WindraNatan/Coaster/PRD_Smart_Hydration_Coaster.md

# PRODUCT REQUIREMENTS DOCUMENT (PRD) & SPESIFIKASI TEKNIS — FINAL
## Smart Hydration Coaster: Sistem Kendali & Pemantau Hidrasi Adaptif
**Versi:** 2.0 FINAL (keputusan terkunci, 2026-10-07)
**Target Mata Kuliah:** RSK-352 Sistem Kendali (2 SKS) & RSK-354 Internet of Things (3 SKS)
**Program Studi:** S1 Rekayasa Sistem Komputer, FMIPA Universitas Tanjungpura
**Dasar revisi:** hasil audit teknis 2026-10-05 (`AUDIT_Smart_Hydration_Coaster.md`). Semua keputusan pada dokumen ini final dan mengikat implementasi kode.

---

## 1. Gambaran Umum dan Tujuan Sistem

Smart Hydration Coaster adalah tatakan gelas pintar berbasis ESP32 yang mendisiplinkan konsumsi air minum melalui verifikasi berat fisik secara *closed-loop* dan adaptasi suhu ruangan.

Aplikasi pengingat minum di ponsel bekerja *open-loop*: alarm berbunyi tanpa verifikasi apakah user benar-benar minum. Sistem ini menutup umpan balik tersebut dengan memantau berat gelas di atas tatakan (load cell + HX711), mendeteksi percobaan *anti-cheat*, mengenali gelas kosong dan gelas yang lupa dikembalikan, serta memodulasi durasi timer dari suhu dan kelembaban ruangan (DHT11). Pemantauan dan laporan harian tampil pada *web dashboard*.

---

## 2. Spesifikasi Perangkat Keras

### 2.1 Sensor
1. **Load Cell 1 kg / 5 kg + modul ADC HX711 24-bit.** Mengukur massa total gelas + air dalam gram secara real-time. Prinsip: perubahan resistansi jembatan Wheatstone diperkuat PGA internal HX711, dikonversi 24-bit.
2. **DHT11** (suhu 0–50 °C, RH 20–90%). Variabel input lingkungan untuk memodulasi durasi timer pada mode adaptif.

### 2.2 Aktuator (keduanya modul dengan driver onboard)
1. **Modul Active Buzzer 3-pin** (VCC/GND/I-O). Modul sudah berisi transistor PNP S8550 + resistor base onboard, sehingga pin GPIO hanya menggerakkan basis transistor. **Polaritas ACTIVE-LOW** (tanda `低电平触发`: LOW = bunyi). Tidak perlu transistor, resistor, atau dioda eksternal.
2. **Modul Vibration Motor DC (motor koin) 3-pin** (VCC/GND/IN). Modul sudah berisi transistor NPN S8050 + resistor onboard; arus motor 60–90 mA tidak melewati pin GPIO. **Active-HIGH** (HIGH = getar) dan mendukung PWM. Firmware memakai pola pulsing digital on/off; kemampuan PWM modul dicatat sebagai cadangan, bukan klaim implementasi.

### 2.3 Tabel Pinout ESP32 DevKit V1

| Komponen | Kaki modul | Pin ESP32 | Arah | Keterangan |
| :--- | :--- | :--- | :--- | :--- |
| HX711 | DT/DOUT | **GPIO 16** | Input | Data ADC 24-bit; DOUT high ≈ DVDD 2,6 V (aman untuk 3,3 V) |
| | SCK/CLK | **GPIO 4** | Output | Clock sinkronisasi |
| | VCC/GND | VIN 5V / GND | Daya | Eksitasi load cell |
| DHT11 | DATA | **GPIO 19** | I/O | Single-wire; VCC 3,3 V |
| Buzzer (modul) | I-O | **GPIO 18** | Output | **Active-LOW** (PNP S8550); **VCC wajib 3,3 V** agar transistor mati saat GPIO HIGH (3,3 V) |
| Motor getar (modul) | IN | **GPIO 17** | Output | **Active-HIGH** (NPN S8050); VCC ke VIN 5 V, GPIO2 dihindari karena strapping pin |

Catatan desain: motor dipindah dari GPIO2 (strapping pin, berbagi LED onboard) ke GPIO17 agar boot ESP32 tidak memicu getaran parasit.

---

## 3. Skenario Operasional (8 skenario; 6 di antaranya wajib sesuai requirement)

Stabilitas di seluruh dokumen dan kode didefinisikan tunggal: **berat dalam band ±3 g dari kandidat stabil selama 1.500 ms** (`STABILITY_TIME_MS = 1500`, `STABILITY_BAND = 3.0`), dievaluasi per sampel 100 ms. Ini angka yang sama di firmware, Python test, dan web.

1. **Peletakan gelas berisi air.** Gelas ditaruh, berat ≥ 35 g masuk STABLE; setelah stabil 1,5 s dan berat > W_kosong + 15 g, berat disimpan sebagai baseline dan timer dimulai.
2. **Durasi timer (manual vs adaptif).** Manual: nilai menit dari dashboard. Adaptif: dihitung dari DHT11 (§4.3).
3. **`STATE_ALERT_DRINK`:** timer habis tanpa minum → buzzer + motor berpola 500 ms ON/500 ms OFF sampai gelas diangkat, plus banner + notifikasi web.
4. **Minum sah:** angkat → taruh kembali dengan ΔW turun ≥ 20 g dan air tersisa → alarm mati, volume ditambah ke akumulasi harian, baseline diperbarui, timer di-reset.
5. **`STATE_ALERT_CHEAT`:** gelas ditaruh kembali dengan ΔW < 20 g → buzzer + motor berpola 150 ms ON/150 ms OFF sampai gelas diangkat lagi untuk minum sungguhan.
6. **`STATE_ALERT_REFILL` (gelas kosong):** gelas ditaruh dengan 35 g ≤ W ≤ W_kosong + 15 g → alarm isi ulang (750 ms ON/750 ms OFF) sampai diisi ulang.
7. **`STATE_ALERT_REFILL` (gelas hilang):** gelas diangkat > `MAX_LIFT_DURATION_MS` (3 menit normal / 10 detik demo) → alarm lupa-gelas. Alarm hanya selesai jika gelas kembali: berisi air → TIMING; kosong → berpindah ke alert gelas kosong (alarm tetap aktif, tidak pernah hilang tanpa resolusi).
8. **Minum via sedotan / isi ulang di atas tatakan:** tanpa mengangkat gelas, ΔW turun ≥ 20 g dicatat sebagai minum; ΔW naik ≥ 30 g dicatat sebagai isi ulang; keduanya memperbarui baseline dan me-reset timer.

---

## 4. Arsitektur Sistem Kendali (RSK-352)

### 4.1 Variabel Kendali (Human-in-the-Loop)
- **PV:** massa air di gelas (W_total − W_kosong) dan waktu tunggu sejak tegukan terakhir.
- **SP:** pengurangan massa minimal ΔW ≥ 20 g dalam batas waktu T_target.
- **Environmental input:** suhu dan RH dari DHT11 yang memodulasi T_target.
- **MV:** sinyal digital on/off dua aktuator dengan pola modulasi per status (§4.5). Modul motor PWM-capable; firmware memakai pulsing digital.
- **Disturbance:** getaran meja, derau ADC HX711, hentakan peletakan. Diredam Moving Average Filter (jendela 10 sampel, sampel 10 Hz) + hysteresis CUP_ON 35 g / CUP_OFF 25 g + stabilitas berbasis waktu 1,5 s.

### 4.2 Diagram Blok Closed-Loop

```mermaid
flowchart TD
    DHT["Sensor Lingkungan: DHT11 (Suhu & RH)"] -->|"Modulasi Interval Adaptif"| SP_GEN["Generator Setpoint Waktu & Target Minum"]
    USER_SP["Input Setpoint Manual (Web Dashboard)"] --> SP_GEN

    SP_GEN -->|"Setpoint (SP)"| COMP["Komparator & Evaluasi State (ESP32)"]
    COMP -->|"Status / Event"| CTRL["Kontroler: 7-State FSM + Modulator Aktuator"]
    CTRL -->|"Sinyal Digital Pulsa"| ACT["Aktuator Ganda: Buzzer + Motor Getar"]
    CTRL -.->|"Event Payload"| WEB_NOTIF["Web Dashboard (banner + notifikasi)"]

    ACT -->|"Stimulus Suara & Getar"| HUMAN["User (Human-in-the-Loop)"]
    WEB_NOTIF -.->|"Stimulus Visual"| HUMAN

    HUMAN -->|"Aksi Fisik: Minum / Angkat / Isi Ulang"| PLANT["Plant: Gelas & Massa Air"]
    DIST["Disturbance: Getaran Meja & Derau ADC"] --> PLANT
    PLANT --> SENSOR["Sensor: Load Cell + HX711"]
    SENSOR --> FILTER["Signal Conditioning: Moving Average + Hysteresis + Stabilitas Waktu"]
    FILTER -->|"Feedback PV"| COMP
```

### 4.3 Kendali Adaptif Kontinu Berbasis Aturan & Interval Kustom

`adaptive_controller.h` mengimplementasikan interpolasi linier sepotong-sepotong (*piecewise-linear interpolation*) tanpa lompatan diskrit terhadap interval dasar pilihan *user* ($T_{base}$, *default* 30 menit, dapat dikustomisasi 1 s.d. 180 menit melalui perintah `i<menit>` atau *dashboard*):

$$T_{target} = \max\left(5 \text{ detik},\ \text{round}(T_{base} \times k_{temp}(T) \times k_{hum}(RH))\right)$$

| Titik Jangkar | Rentang / Nilai | Faktor |
| :--- | :--- | :--- |
| Dingin | $T \le 18\,^\circ\text{C}$ | $k_{temp} = 1{,}20$ |
| Sejuk s.d. Normal | $18\,^\circ\text{C} < T \le 26\,^\circ\text{C}$ | Interpolasi linier $1{,}20 \to 1{,}00$ (pada $22\,^\circ\text{C}$ bernilai $1{,}10$) |
| Normal s.d. Panas | $26\,^\circ\text{C} < T < 34\,^\circ\text{C}$ | Interpolasi linier $1{,}00 \to 0{,}50$ (pada $30\,^\circ\text{C}$ bernilai $0{,}75$) |
| Panas | $T \ge 34\,^\circ\text{C}$ | $k_{temp} = 0{,}50$ |
| Kering | $RH \le 30\%$ | $k_{hum} = 0{,}85$ |
| Transisi RH | $30\% < RH < 50\%$ | Interpolasi linier $0{,}85 \to 1{,}00$ (pada $40\%$ bernilai $0{,}925$) |
| Lembab Normal | $RH \ge 50\%$ | $k_{hum} = 1{,}00$ |

Contoh pada $T_{base} = 30\text{ menit}$: $34\,^\circ\text{C}/55\% \to 15{,}00\text{ menit}$; $30\,^\circ\text{C}/55\% \to 22{,}50\text{ menit}$; $22\,^\circ\text{C}/75\% \to 33{,}00\text{ menit}$; $18\,^\circ\text{C}/75\% \to 36{,}00\text{ menit}$. Rumus ini identik 1:1 di *firmware*, `test_simulation.py`, dan `web/fsm.js`.

### 4.4 FSM 7-State (stabilitas berbasis waktu)

```mermaid
stateDiagram-v2
    [*] --> STATE_IDLE
    STATE_IDLE --> STATE_STABLE : W >= 35 g
    STATE_STABLE --> STATE_IDLE : W < 25 g
    STATE_STABLE --> STATE_ALERT_REFILL : stabil 1,5s & W <= W_kosong+15 [EMPTY_CUP]
    STATE_STABLE --> STATE_TIMING : stabil 1,5s & W > W_kosong+15g

    STATE_TIMING --> STATE_LIFTED : W < 25g
    STATE_TIMING --> STATE_TIMING : stabil & W turun >= 20g (sedotan) / naik >= 30g (refill di tatakan)
    STATE_TIMING --> STATE_ALERT_DRINK : timer habis

    STATE_ALERT_DRINK --> STATE_LIFTED : W < 25g
    STATE_ALERT_CHEAT --> STATE_LIFTED : W < 25g
    STATE_ALERT_DRINK --> STATE_TIMING : stabil & turun >= 20g (minum) / naik >= 30g (isi ulang)
    STATE_ALERT_CHEAT --> STATE_TIMING : stabil & turun >= 20g (minum) / naik >= 30g (isi ulang)

    STATE_LIFTED --> STATE_ALERT_REFILL : diangkat >= batas waktu [MISSING_CUP]
    STATE_LIFTED --> STATE_ALERT_REFILL : ditaruh stabil & W <= W_kosong+15g [EMPTY_CUP]
    STATE_LIFTED --> STATE_ALERT_CHEAT : ditaruh stabil & |delta| < ambang
    STATE_LIFTED --> STATE_TIMING : ditaruh stabil & turun >= 20g [minum sah]
    STATE_LIFTED --> STATE_TIMING : ditaruh stabil & naik >= 30g [isi ulang]

    STATE_ALERT_REFILL --> STATE_TIMING : gelas kembali & W > W_kosong+15g (menyelesaikan EMPTY maupun MISSING)
    STATE_ALERT_REFILL --> STATE_LIFTED : gelas diangkat lagi (kasus EMPTY_CUP)
```

Semantik "stabil": kandidat berat disimpan saat berat berubah >3 g; transisi terjadi hanya bila berat bertahan dalam ±3 g selama 1.500 ms. Timer stabilitas di-reset di setiap perpindahan state. Semua arah naik/turun pada setiap state mengikuti satu tabel transisi (ΔW turun ≥ 20 g = minum, naik ≥ 30 g = isi ulang).

**Setiap keputusan ΔW wajib menunggu berat baru stabil.** Cabang minum dan isi ulang di `STATE_TIMING`, `STATE_ALERT_DRINK`, dan `STATE_ALERT_CHEAT` tidak boleh dieksekusi pada sampel pertama yang melewati ambang; ia menunggu dulu `isStable()` terpenuhi untuk berat baru. Alasannya fisik: mengangkat gelas bukan satu langkah, melainkan turun bertahap sekitar 46 g per sampel pada 10 Hz. Tanpa gerbang ini, delapan sampel saat mengangkat gelas terbaca sebagai delapan kali minum berturut-turut (pernah terukur 4–6 minum palsu per pengangkatan, total melonjak ke 276 g), timer terus ter-reset sehingga `ALERT_DRINK` tidak pernah muncul, baseline ikut rusak ke nilai terangkat, dan `ALERT_CHEAT` menjadi mustahil dicapai karena selisihnya selalu terbaca sebagai minum sah. Gerbang yang sama berlaku untuk sedotan, isi ulang di atas tatakan, dan pemulihan dari `ALERT_REFILL`.

### 4.5 Pola Modulasi Aktuator

Firmware memakai pulsing non-blocking; fase toggle di-reset setiap kali masuk atau keluar mode alert agar ketukan pertama selalu konsisten. Buzzer active-LOW dan motor active-HIGH digerakkan lewat helper `writeActuator(pin, on, activeLow)` sehingga polaritas masing-masing modul dijaga konstanta.

| Status | Pola | Pesan |
| :--- | :--- | :--- |
| `ALERT_DRINK` | 500 ms ON / 500 ms OFF | "Waktunya minum!" |
| `ALERT_CHEAT` | 150 ms ON / 150 ms OFF | "Berat hanya turun < 20 g, minum yang sungguhan." |
| `ALERT_EMPTY_CUP` | 750 ms ON / 750 ms OFF | "Air habis, isi ulang." |
| `ALERT_MISSING_CUP` | 750 ms ON / 750 ms OFF | "Gelas belum kembali ke tatakan." |

Notifikasi web dikirim satu kali per perubahan jenis alert (bukan berulang); banner tetap tampil selama alert aktif.

---

## 5. Arsitektur IoT & Protokol Komunikasi (RSK-354)

> **Status:** Phase 2. Fase 1 berjalan standalone (Serial + simulator web). Integrasi dimulai setelah kalibrasi load cell selesai.

### 5.1 Protokol di sisi ESP32 (jawaban definitif)
- **Transport:** Wi-Fi mode STA, 2,4 GHz (ESP32 tidak mendukung 5 GHz).
- **Protokol:** HTTPS REST ke Firebase Realtime Database, port 443, body JSON.
- **Implementasi firmware:** `HTTPClient` + `WiFiClientSecure` (`setInsecure()`) langsung di `cloud_sync.h`, tanpa library eksternal; token tidak diperlukan karena rules RTDB terbuka terkontrol.
- **Endpoint:**

| Arah | Operasi | Path | Kapan |
| :--- | :--- | :--- | :--- |
| ESP32 → cloud | PATCH | `/smart_coaster/telemetry.json` | saat transisi state + heartbeat tiap 5 s |
| ESP32 ← cloud | GET | `/smart_coaster/config.json` | saat boot + tiap 15 detik |
| Browser ↔ cloud | REST polling 2,5 s | `/smart_coaster` | realtime |

- **Kadens dikendalikan:** push tidak dilakukan per iterasi loop; cukup on-change + heartbeat 5 s agar aman terhadap kuota Spark.
- **Riwayat harian** tidak ditulis ke cloud; dihitung di web (`localStorage`) per tanggal perangkat.
- **Auth:** Fase 2 tanpa login (satu perangkat, rules terbuka terkontrol). Anonymous Auth opsional untuk merapikan rules. Email/password hanya jika kelak multi-user.

### 5.2 Skema Database

```json
{
  "smart_coaster": {
    "telemetry": { "weight_g": 380.0, "water_ml": 250.0, "temp_c": 28.5, "humidity_pct": 62.0,
                   "fsm_state": "TIMING", "alert_reason": "NONE", "remaining_sec": 1420, "target_interval_min": 22.5 },
    "daily": {
      "2026-10-07": { "total_ml": 735, "drink_count": 3, "refill_count": 2, "cheat_count": 1 }
    },
    "config": { "timer_mode": "AUTO_DHT", "manual_interval_min": 30, "empty_cup_weight_g": 130, "min_drink_delta_g": 20, "max_lift_duration_sec": 180 },
    "logs": [ { "time": "14:20:10", "event": "Minum 245 ml", "drink_ml": 245 } ]
  }
}
```

Laporan harian berkunci tanggal sehingga hari baru otomatis membuka node baru; tidak perlu cron reset, dan node lama menjadi riwayat.

---

## 6. Spesifikasi Aplikasi Web & PWA (`web/index.html`)

1. **Progressive Web App (PWA):** Dilengkapi `web/manifest.json`, `web/sw.js` (*offline cache*), dan `web/icon.svg` sehingga dapat di-*install* sebagai aplikasi mandiri di ponsel Android maupun *desktop*.
2. **Tiga Mode Koneksi (*Real-Time*):**
   - **Simulator Mandiri:** Menjalankan mesin `CoasterFSM` 1:1 di *browser* dengan 8 skenario otomatis dan percepatan waktu (`x1` s.d. `x600`).
   - **USB Live (Web Serial API):** Terhubung langsung ke ESP32 melalui kabel USB (`115200 baud`), membaca telemetri *real-time* sekaligus mengirim perintah dua arah (`t`, `c`, `e<g>`, `i<mnt>`, `d`, `m`, `r`).
   - **Cloud Firebase RTDB:** Sinkronisasi *real-time* melalui HTTPS REST ke `/smart_coaster` (baik dari *task* Core 0 `cloud_sync.h` pada ESP32 maupun *gateway* otomatis dari *browser* saat USB Live terhubung).
3. **Kartu Telemetri & Progres Target Harian:** Menampilkan berat aktual, volume air, suhu/RH, *countdown* aktif, serta *progress bar* persentase capaian target minum harian (*default* `2000 ml`, dapat dikustomisasi).
4. **Banner Alert, Web Notification & Haptik:** Mengirim notifikasi *browser* dan getaran ponsel (`navigator.vibrate`) satu kali setiap pergantian status *alert*.
5. **Panel Konfigurasi Pewaktuan:** Mendukung toggle mode **Adaptif Kontinu DHT11 (`AUTO_DHT`)** vs **Manual Tetap (`MANUAL`)**, kustomisasi interval dasar `1` s.d. `180` menit, dan kalibrasi berat gelas kosong (`35` s.d. `300 g`).

---

## 7. Struktur Codebase

```
SmartHydrationCoaster/          <- sketch utama; buka folder ini di Arduino IDE
    SmartHydrationCoaster.ino   <- firmware utama
    config.h                    <- pin, ambang, titik jangkar adaptif kontinu, faktor kalibrasi
    filter.h                    <- moving average (jendela 10 sampel)
    adaptive_controller.h       <- interpolasi kontinu suhu/kelembaban DHT11
    fsm.h                       <- 7-state FSM
    cloud_sync.h                <- sinkronisasi non-blocking Firebase RTDB pada Core 0 ESP32
tools/
    kalibrasi/kalibrasi.ino
    test_hardware/test_hardware.ino
    test_loadcell/test_loadcell.ino
    uji_fsm/uji_fsm.cpp         <- harness kompilasi C++ di PC (52 pemeriksaan)
test_simulation.py              <- port 1:1 dari fsm.h & adaptive_controller.h (21 skenario)
web/
    fsm.js                      <- kelas CoasterFSM mirror 1:1 fsm.h (diuji fsm.test.js)
    fsm.test.js                 <- regresi Node untuk fsm.js
    index.html                  <- aplikasi PWA (Simulator + USB Web Serial + Cloud Firebase)
    manifest.json               <- manifest instalasi PWA Android/Desktop
    sw.js                       <- service worker untuk mode offline
    icon.svg                    <- ikon aplikasi
docs/pemodelan_sistem_kendali.md
PRD_Smart_Hydration_Coaster.md  <- dokumen ini
```

Aturan sketch Arduino: satu sketch = satu folder, nama file `.ino` wajib sama dengan nama folder. Skrip uji (`kalibrasi`, `test_hardware`, `test_loadcell`) masing-masing berdiri sebagai sketch sendiri di `tools/`.

---

## 8. Casing Sasis Kapsul 28 mm

1. **Desain final:** sasis kapsul, bukan PVC foam board — kompartemen belakang 28,0 mm, bibir depan 23,2 mm. Model parametriknya `cad/coaster_casing.scad`; rincian dimensi komponen, grid perfboard, dan bukaan USB di `CLAUDE.md` §5.
2. **Piringan akrilik** bertumpu pada ujung bebas load cell (puncak 24,2 mm, 1,0 mm di atas bibir depan) sehingga gelas menumpu hanya pada piringan. Modul buzzer, DHT11, dan motor ditempel datar. Kabelnya disolder permanen ke papan di satu ujung dan memakai konektor female di ujung modul, jadi sensor masih bisa dicabut tanpa menyentuh sambungan papan.

---

## 9. Pengujian dan Kriteria Penerimaan

| # | Skenario | Uji otomatis | Uji manual |
| :--- | :--- | :--- | :--- |
| 1 | Timer adaptif kontinu DHT11 & kustomisasi interval (34 °C → 15,0 mnt; 30 °C → 22,5 mnt; 22 °C → 33,0 mnt; 18 °C → 36,0 mnt) | `test_simulation.py` & `uji_fsm.cpp` | bandingkan Serial Monitor vs dashboard |
| 2 | Taruh gelas → TIMING setelah stabil 1,5 s | idem | taruh gelas 380 g |
| 3 | Timer habis → ALERT_DRINK (pola 500/500) | idem | dengar/rasakan pola bunyi & getar |
| 4 | Anti-cheat ΔW < 20 g → ALERT_CHEAT (pola 150/150) | idem | sentuh gelas tanpa minum |
| 5 | Minum sah → timer reset, total naik, drinkCount +1 | idem | minum ≥ 20 g |
| 6 | Gelas kosong → ALERT_EMPTY_CUP | idem | taruh gelas kosong |
| 7 | Gelas diangkat > batas → ALERT_MISSING_CUP; evaluasi anti-cheat/minum saat kembali | idem | angkat > 3 mnt (10 s demo) |
| 8 | Sedotan (−20 g) & tuang langsung (+30 g) di atas tatakan | idem | uji manual |
| 9 | Hysteresis CUP_ON/CUP_OFF 35/25 g | idem | angkat-taruh berulang di dekat ambang |
| 10 | Regresi angkat bertahap (−46 g/sampel): 0 minum palsu, baseline utuh, lanjut ke ALERT_CHEAT | idem | angkat gelas penuh lalu taruh kembali tanpa minum |
| 11 | Tekan-lepas gelas saat TIMING (+35 g lalu kembali dalam 5 s): refillCount tetap 0, 0 minum palsu, baseline utuh | idem | tekan pelan gelas penuh di tatakan lalu lepaskan |
| 12 | Kalibrasi berat gelas kosong saat gelas berisi di tatakan: baseline menyesuaikan berat aktual, 0 isi ulang palsu | idem | dengan gelas 380 g di tatakan, tekan "Simpan Gelas" |

Skenario 10 wajib ada karena skenario 2 sampai 9 semuanya mengangkat gelas dalam satu langkah, sehingga cacat "keputusan ΔW tanpa gerbang stabilitas" lolos dari seluruh rangkaian uji tersebut. Tanpa gerbang itu, skenario 10 gagal dengan 6 minum palsu dan total 276 g sementara skenario 1 sampai 9 tetap hijau.

Tiga port harus lulus skenario yang sama: `test_simulation.py` (21 skenario), `tools/uji_fsm/uji_fsm.cpp` (mengompilasi `fsm.h` dan `adaptive_controller.h` asli di PC, 52 pemeriksaan), dan `web/fsm.js` (diuji `node web/fsm.test.js`; 30 asersi untuk 4 skenario regresi K1/K3, plus 8 tombol skenario di `web/index.html`). Prosedur kalibrasi: `tools/test_loadcell` dengan beban acuan 500 g menghasilkan faktor `450.7f` yang dikunci di `config.h`, serta uji derau statis 20 sampel menghasilkan rata-rata `500.10 g` (rentang `499.98 g` sampai `500.19 g`, *peak-to-peak jitter* `0.21 g`).

---

## 10. Status Implementasi & Ekosistem

- **Perangkat Keras & Kalibrasi (Selesai):** ESP32 DevKit V1 + *load cell* 5 kg (`450.7f`, *jitter* statis `0.21 g`) + DHT11 + *active buzzer* PNP S8550 (`GPIO18`, `VCC` ke `3V3`) + motor getar NPN S8050 (`GPIO17`, `VCC` ke `5V`).
- **Kendali & Pewaktuan (Selesai):** Mesin 7-*state* FSM dengan gerbang stabilitas waktu `1500 ms` + kontroler adaptif kontinu DHT11 (`adaptive_controller.h`) + kustomisasi interval *user* (`1` s.d. `180` menit).
- **Aplikasi & IoT (Selesai):** PWA `web/index.html` yang dapat di-*install* di Android/Desktop dengan tiga mode operasi (*Simulator*, *USB Web Serial Live*, dan *Cloud Firebase RTDB*) serta modul sinkronisasi *non-blocking* Core 0 (`cloud_sync.h`).

---

## 11. Perubahan Keputusan penting dibanding draft (ringkas)

Motor pindah GPIO2 → GPIO17. Interval dasar dikunci 30 menit. Stabilitas berbasis waktu 1,5 s ±3 g (bukan hitung sampel). Polaritas aktuator terdokumentasi (buzzer active-LOW, motor active-HIGH) dengan helper `writeActuator`. Nama `fuzzy_controller.h` → `adaptive_controller.h` dan klaim Fuzzy Sugeno dihapus. Struktur sketch dirapikan agar dapat dikompilasi. Protokol komunikasi ditetapkan: HTTPS REST Firebase RTDB via `HTTPClient` + `WiFiClientSecure` (`setInsecure`), tanpa library eksternal.

Ditambahkan setelah uji perangkat nyata 2026-10-08: setiap keputusan ΔW (minum, sedotan, isi ulang di tatakan, pemulihan dari ALERT_REFILL) menunggu berat baru stabil lebih dulu. Sebelumnya keputusan diambil pada sampel pertama yang melewati ambang, sehingga mengangkat gelas penuh menghasilkan deretan minum palsu, merusak baseline, dan membuat ALERT_CHEAT tidak pernah bisa tercapai di perangkat. Perubahan ini diterapkan serentak di `fsm.h`, `test_simulation.py`, dan `web/index.html` beserta skenario regresi barunya.

2026-10-21 (eksekusi `docs/arsip/AUDIT_SISTEM_DAN_WEB.md`): K1 anti tekan-lepas via `REFILL_CONFIRM_MS` 5 s (isi ulang pending, dibatalkan bila berat kembali ke baseline); K3 flag `calibrationAlign` agar kalibrasi dengan gelas berisi menyelaraskan baseline tanpa isi ulang palsu; kelas JS dipindah dari `web/index.html` ke `web/fsm.js` + `web/fsm.test.js`; urutan Reset Harian di web disimpan-sebelum-reset; kelas log alarm `ev-*` dan urutan tutup port serial (cancel reader → await loop → releaseLock → close) diperbaiki; dokumentasi (CLAUDE.md, docs/arsip/HANDOFF_AGENT.md, PRD) diselaraskan dengan kode: DHT11 GPIO19, HTTPClient/WiFiClientSecure, heartbeat 5 s, poll 15 s, tanpa NTP dan tanpa endpoint `/daily/`, casing sasis kapsul 28 mm. K1 juga memulihkan state & timer pra-isi-ulang saat pembatalan (tekan-lepas tak lagi membunuh alarm atau menunda timer); K3 re-arm saat gelas kosong teramati di `ALERT_REFILL` (flag tak lagi basi setelah lift); regresi baru: skenario 20 (timer restore) & 21 (flag basi) di ketiga port (`test_simulation.py`, `tools/uji_fsm/uji_fsm.cpp`, `web/fsm.test.js`).
