WindraNatan/Coaster/cad/rear.stl

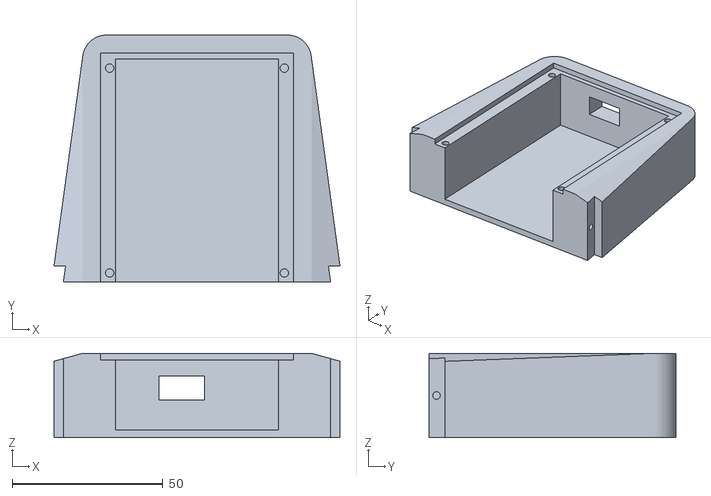
[picture p1: CAD file, 2026-10-22]
cad/rear.stl
95.0 x 82.0 x 28.0
