WindraNatan/Coaster/cad/front.stl

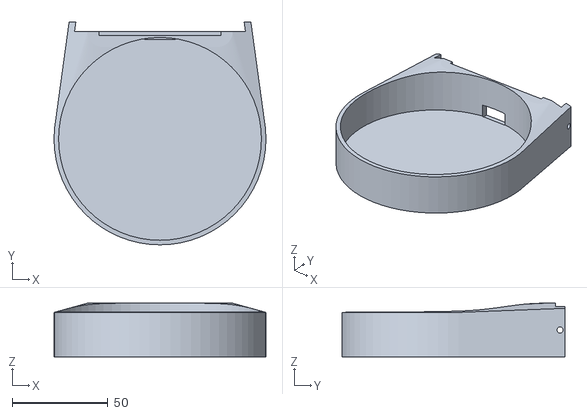
[picture p2: CAD file, 2026-10-22]
cad/front.stl
110.8 x 116.4 x 28.0
