WindraNatan/Coaster/cad/coaster_casing.stl

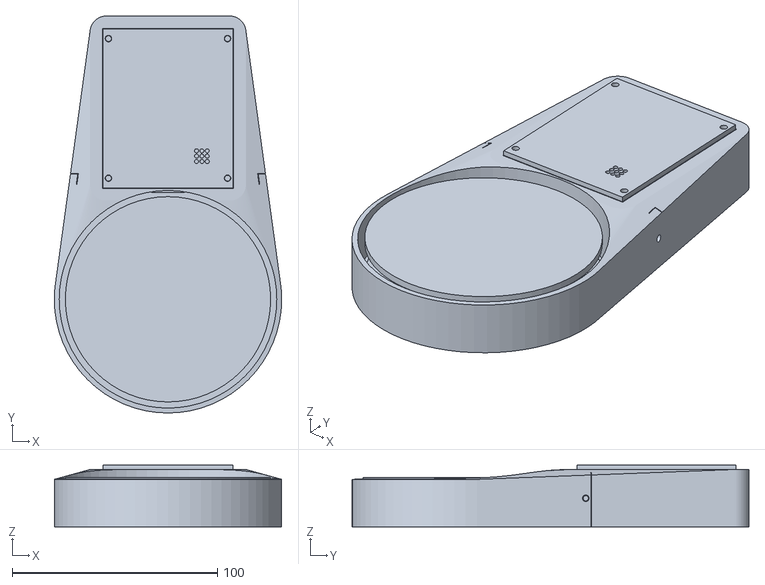
[picture p3: CAD file, 2026-10-22]
cad/coaster_casing.stl
110.8 x 193.4 x 30.2
