WindraNatan/Coaster/cad/lid.stl

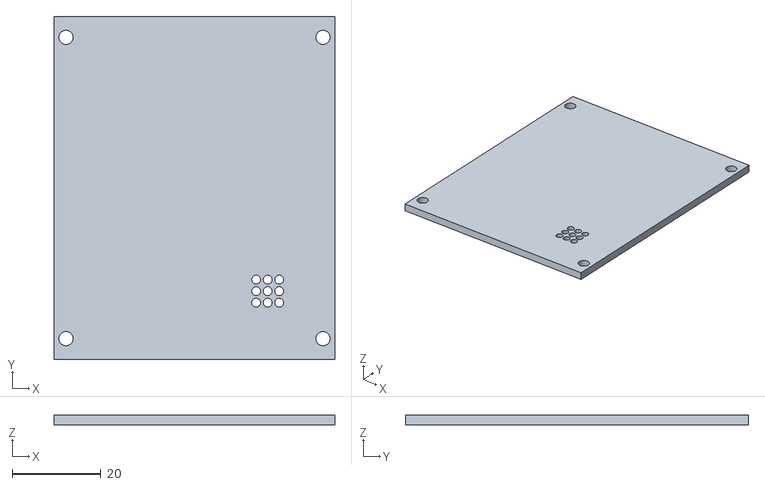
[picture p4: CAD file, 2026-10-22]
cad/lid.stl
63.4 x 77.4 x 2.20
