WindraNatan/Coaster/cad/coaster_casing_chassis.stl

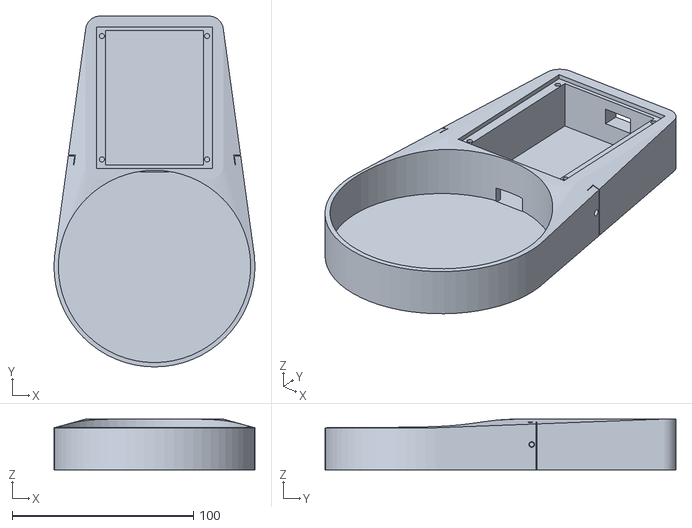
[picture p5: CAD file, 2026-10-21]
cad/coaster_casing_chassis.stl
110.8 x 193.4 x 28.0
