WindraNatan/Coaster/docs/arsip/AUDIT_FIX_2026-11-03.md

# Laporan Perbaikan — Sinkronisasi & Latensi

Tanggal: 2026-11-03. Sumber: audit 10 temuan + 11 advisory.

## Perbaikan (tanpa reflash)

| # | Perbaikan | Berkas |
|---|---|---|
| 1 | Saklar mute tidak lagi membalik sendiri: `mutedFrom(cfg, tlm)` — config menang, telemetry hanya cadangan | `web/fsm.js`, `web/index.html:982` |
| 2 | Tombol Reset ditahan di mode cloud (statistik milik firmware; reset dari browser selalu berkedip kembali) | `web/index.html:671` |
| 3 | `muted` dihapus dari payload telemetry web — satu penulis, tidak lagi menimpa echo firmware | `web/index.html:914` |
| 4 | App hanya menarik `telemetry.json` + `config.json` (bukan seluruh node termasuk `daily/` tanpa batas) | `app/lib/main.dart:547` |
| 5 | Dead code `clearDeviceUid` dihapus (0 pemanggil) | `app/lib/auth.dart` |
| 6 | `probe` (data uji saya) dihapus dari `config.json` produksi | konsol RTDB |
| 7 | CI menjalankan semua tes sebelum deploy + pemicu diperluas ke `app/`, `tools/`, rules | `.github/workflows/pages.yml` |
| 8 | Komentar AI-slop: tidak ada yang dihapus — komentar yang ada menjelaskan *alasan* (K1/K2/K3/C4, urutan prioritas), bukan mengulang kode | — |

## Perbaikan firmware (butuh 1× reflash, sudah ditulis)

| Perubahan | Berkas |
|---|---|
| Poll config 15 dtk → **3 dtk**, dan saat config berubah paksa push telemetry (`lastPushMs = now - 5000UL`) | `cloud_sync.h:344` |
| Perintah lokal (`c/e/i/d/m/q`) menandai `configDirty`; `cloudTask` (core 0) yang PATCH — bukan `loop()` core 1 | `cloud_sync.h:322`, `.ino:47` |
| **Urutan benar**: unggah pending *sebelum* GET, dan `if (!configDirty)` mengunci penerapan GET — perintah yang jatuh saat GET tidak tertimpa dan NVS tidak ikut tertimpa | `cloud_sync.h:359` |

Advisory `q lokal + poll jatuh tempo` terbukti benar lewat model: kode lama membalik `muted`, menulis NVS basi, PATCH hilang. Kode baru mempertahankan nilai lokal, flag tetap terpasang.

## Verifikasi

- `web/fsm.test.js` — 22 lulus, termasuk regresi presedensi muted (#22); **mutation-checked**: membalik urutan → gagal.
- `web/daily-history.test.js` — lulus.
- `test_simulation.py` — 21/21.
- `tools/cad_check/verify_stackup.py` — 60/60.
- `tools/cek_aturan_berkas.py` — lolos.
- `flutter analyze` — bersih; `flutter test` — **48/48**, termasuk tes baru `telemetry.muted basi tidak menimpa config.muted`; **mutation-checked** (`main.dart:1031` dibalik → gagal, dipulihkan → lulus).
- Browser nyata (headless): mode cloud klik Reset → `Reset statistik harus dari alat…`; mode sim → reset normal; mock fetch config `muted:true` + telemetry `false` → saklar ON. Nol error JS.
- `tools/uji_fsm.exe` tidak bisa dieksekusi di shell ini (policy wrapper: `command not found` meski PE32 valid, DLL lengkap). Tidak berisiko: `fsm.h`/`adaptive_controller.h` tidak disentuh; paritas ditutup python 21 + JS 22 + flutter 48.

## Menunggu Anda

1. **Reflash firmware** (batch di atas) lewat Arduino IDE — satu kali colok USB.
2. **Kode klaim `FYXFRB4N`** — masukkan di aplikasi atau halaman Akun bila penautan belum selesai.

## Ditunda

- Heartbeat `hb` (deteksi alat mati) — fitur, bukan bagian dari keluhan ini; payload web juga perlu ikut mengirim `hb` agar tidak ditandai mati keliru. Tambahkan bersamaan dengan firmware batch berikutnya.
