WindraNatan/Coaster/SmartHydrationCoaster/cloud_sync.h

#ifndef CLOUD_SYNC_H
#define CLOUD_SYNC_H

#include <Arduino.h>
#include "config.h"
#include "fsm.h"
#include "session_gate.h"

#if defined(ESP32)
#include <WiFi.h>
#include <WiFiClientSecure.h>
#include <WiFiManager.h>
#include <HTTPClient.h>
#include <Preferences.h>
#include <ESPmDNS.h>
#include <esp_mac.h>

// ponytail: satu transport cloud saja (HTTPS REST ke Firebase RTDB). MQTT sengaja
// dilewat: RTDB sudah push realtime + last-known state, dan konsumen tambahan
// (app mobile nanti) cukup pakai node yang sama lewat skema JSON di bawah.
// Upgrade: publish PubSubClient paralel (~30 baris, additive) hanya jika perlu
// mode LAN/demo tanpa internet.
struct CloudSnapshot {
    float weightG;
    float waterMl;
    float tempC;
    float humPct;
    char stateStr[20];
    uint32_t remSec;
    float targetMin;
    float totalMl;
    uint16_t drinkCnt;
    uint16_t refillCnt;
    uint16_t cheatCnt;
    bool muted;
    bool standby;
};

static volatile bool cloudTaskRunning = false;
static CloudSnapshot snap = {};
static portMUX_TYPE snapMux = portMUX_INITIALIZER_UNLOCKED;

// Siapa yang menentukan tidur: perintah lokal (z/x) atau session.json. Aturannya
// ada di session_gate.h supaya bisa diuji di PC. Ditulis cloudTask (core 0),
// dibaca loop (core 1), makanya semua akses lewat snapMux.
static SessionGate sessionGate;

inline void setLocalStandby(bool sleep) {
    portENTER_CRITICAL(&snapMux);
    sessionGate.local(sleep);
    portEXIT_CRITICAL(&snapMux);
}

inline bool standbyActiveNow() {
    portENTER_CRITICAL(&snapMux);
    bool v = sessionGate.sleep;
    portEXIT_CRITICAL(&snapMux);
    return v;
}
static String activeWifiSsid = WIFI_SSID;
static String activeWifiPass = WIFI_PASSWORD;
static String activeFirebaseUrl = FIREBASE_DB_URL;
static String activeApiKey = FIREBASE_API_KEY;
static String activeUserEmail = FIREBASE_USER_EMAIL;
static String activeUserPassword = FIREBASE_USER_PASSWORD;
static String idToken = "";
static String activeUid = "";
static String refreshToken = "";
static String claimCode = "";
static bool claimPublished = false;
// Salinan kode di node pemilik punya status sendiri: /claims sekali tulis, salinan
// boleh ditulis ulang bila aturannya baru dipasang atau alat di-flash ulang.
static bool claimMirrored = false;
static uint32_t claimRetryAfterMs = 0;
static uint32_t mirrorRetryAfterMs = 0;
// Sekali per boot isi node diperiksa, supaya gerbang NVS tidak buta terhadap
// node yang dihapus atau akun yang berganti.
static bool claimMirrorChecked = false;
static char sessionOwner[40] = "";
static uint32_t tokenExpiryMs = 0;

// Toko token di NVS supaya boot ulang tidak perlu login lagi. Token Firebase berlaku
// 1 jam; kalau sisa waktunya di bawah 5 menit, ambil yang baru.
static const uint32_t TOKEN_MARGIN_MS = 300000UL;
static const uint32_t TOKEN_TTL_MS = 3600000UL;

// Password boleh berisi kutip ganda, backslash, atau karakter kontrol (tempelan dari
// password manager). Tanpa escape, body JSON rusak dan login gagal dengan HTTP 400.
// ponytail: hanya 4 karakter ini yang di-escape. Nama pengguna/password adalah input
// operator lewat serial, bukan data pengguna lain. Kalau kelak ada jalur input lain
// (mis. halaman konfigurasi), ganti dengan encoder JSON penuh.
static String jsonEscape(const String& s) {
    String out;
    out.reserve(s.length() + 8);
    for (size_t i = 0; i < s.length(); i++) {
        char c = s[i];
        switch (c) {
            case '"':  out += "\\\""; break;
            case '\\': out += "\\\\"; break;
            case '\n': out += "\\n"; break;
            case '\r': out += "\\r"; break;
            case '\t': out += "\\t"; break;
            default:   out += c;
        }
    }
    return out;
}

// Ambil nilai string dari JSON tanpa parser penuh. Melompati spasi setelah
// titik dua: API Google (identitytoolkit, securetoken) membalas ber-pretty-print
// ("idToken": "..."), sehingga pencarian pola rapat selalu gagal.
static String jsonField(const String& s, const char* key) {
    String pola = "\"" + String(key) + "\"";
    int k = s.indexOf(pola);
    if (k < 0) return String();
    k += pola.length();
    while (k < (int)s.length() && (s[k] == ' ' || s[k] == '\t')) k++;
    if (k >= (int)s.length() || s[k] != ':') return String();
    k++;
    while (k < (int)s.length() && (s[k] == ' ' || s[k] == '\t')) k++;
    if (k >= (int)s.length() || s[k] != '"') return String();
    k++;
    int e = s.indexOf('"', k);
    if (e < 0) return String();
    return s.substring(k, e);
}
static bool firebaseLogin() {
    if (activeApiKey.length() == 0 || activeUserEmail.length() == 0) return false;
    WiFiClientSecure tls;
    tls.setInsecure();
    HTTPClient http;
    String url = "https://identitytoolkit.googleapis.com/v1/accounts:signInWithPassword?key=" + activeApiKey;
    if (!http.begin(tls, url)) return false;
    http.addHeader("Content-Type", "application/json");
    String body = "{\"email\":\"" + jsonEscape(activeUserEmail) + "\",\"password\":\"" +
                  jsonEscape(activeUserPassword) + "\",\"returnSecureToken\":true}";
    int code = http.POST(body);
    if (code != 200) {
        Serial.printf("[CLOUD] Login gagal (HTTP %d). Cek API key, email, dan password.\n", code);
        http.end();
        return false;
    }
    String res = http.getString();
    http.end();
    // API identitytoolkit mengembalikan JSON ber-pretty-print: ada spasi setelah
    // titik dua ("idToken": "..."). Pencarian harus melompati spasi, kalau tidak
    // login HTTP 200 tetap dianggap gagal.
    idToken = jsonField(res, "idToken");
    activeUid = jsonField(res, "localId");
    if (idToken.length() == 0 || activeUid.length() == 0) {
        Serial.println(F("[CLOUD] Respons login tidak memuat idToken/localId. "
                         "Cek bentuk respons di atas."));
        return false;
    }
    tokenExpiryMs = millis() + TOKEN_TTL_MS;
    String rt = jsonField(res, "refreshToken");
    if (rt.length() > 0) refreshToken = rt;
    Preferences prefs;
    prefs.begin("shc", false);
    prefs.putString("idToken", idToken);
    prefs.putString("uid", activeUid);
    prefs.putString("refreshToken", refreshToken);
    prefs.end();
    Serial.printf("[CLOUD] Login OK, token %u karakter.\n", idToken.length());
    return true;
}

// Token Firebase berlaku satu jam. Tukar refreshToken (disimpan saat login) jadi token
// baru, supaya alat yang menyala berhari-hari tidak bergantung pada satu login awal.
static bool firebaseRefresh() {
    if (refreshToken.length() == 0 || activeApiKey.length() == 0) return false;
    WiFiClientSecure tls;
    tls.setInsecure();
    HTTPClient http;
    String url = "https://securetoken.googleapis.com/v1/token?key=" + activeApiKey;
    if (!http.begin(tls, url)) return false;
    http.addHeader("Content-Type", "application/x-www-form-urlencoded");
    String body = "grant_type=refresh_token&refresh_token=" + refreshToken;
    int code = http.POST(body);
    if (code != 200) { http.end(); return false; }
    String res = http.getString();
    http.end();
    // Sama seperti firebaseLogin: balasan ber-pretty-print, jadi harus lewat
    // jsonField, bukan pencarian pola rapat.
    idToken = jsonField(res, "id_token");
    if (idToken.length() == 0) {
        Serial.println(F("[CLOUD] Respons refresh tidak memuat id_token."));
        return false;
    }
    tokenExpiryMs = millis() + TOKEN_TTL_MS;
    String rt = jsonField(res, "refresh_token");
    if (rt.length() > 0) refreshToken = rt;
    Preferences prefs;
    prefs.begin("shc", false);
    prefs.putString("idToken", idToken);
    prefs.putString("refreshToken", refreshToken);
    prefs.end();
    return true;
}

static bool ensureToken() {
    if (idToken.length() > 0 && activeUid.length() > 0 &&
        (int32_t)(tokenExpiryMs - millis()) > (int32_t)TOKEN_MARGIN_MS) {
        return true;
    }
    return firebaseRefresh() || firebaseLogin();
}

// Node milik akun ini. Rules menolak akses ke /users/<uid> milik orang lain, jadi UID
// wajib ikut di path, bukan hanya di token.
static String userNode() {
    return activeFirebaseUrl + "/users/" + activeUid + "/smart_coaster";
}

static String authSuffix() {
    return idToken.length() > 0 ? "?auth=" + idToken : String("");
}

extern bool demoMode;
extern bool autoDhtTimerMode;
extern bool buzzerMuted;
extern volatile bool configDirty;
extern uint32_t customBaseIntervalMs;
extern CoasterFSM fsm;
extern void updateAdaptiveInterval();
extern void saveConfigToNvs();
extern void saveStatsToNvs();

static float extractJsonFloat(const String& s, const char* key, float fallback) {
    int idx = s.indexOf(key);
    if (idx < 0) return fallback;
    int colon = s.indexOf(':', idx);
    if (colon < 0) return fallback;
    return s.substring(colon + 1).toFloat();
}


// Kode klaim: 8 karakter dari alfabet tanpa huruf mirip (0/O, 1/I/L). Dibuat sekali,
// disimpan di NVS, lalu ditulis ke /claims/<kode> supaya pemilik bisa menautkan alat
// ini ke akunnya. Kode TIDAK boleh sama dengan UID: UID bukan rahasia.
static String makeClaimCode() {
    static const char AB[] = "23456789ABCDEFGHJKMNPQRSTUVWXYZ";
    String out;
    out.reserve(8);
    for (int i = 0; i < 8; i++) out += AB[esp_random() % 31];
    return out;
}

// Tulis /claims/<kode> = UID perangkat. Rules hanya mengizinkan penulisan sekali dan
// hanya kalau nilainya UID si penulis, jadi kode tidak bisa dipalsukan orang lain.
static bool publishClaimCode() {
    if (claimCode.length() == 0 || activeUid.length() == 0) return false;
    WiFiClientSecure tls;
    tls.setInsecure();
    HTTPClient http;
    String url = activeFirebaseUrl + "/claims/" + claimCode + ".json" + authSuffix();
    if (!http.begin(tls, url)) return false;
    http.addHeader("Content-Type", "application/json");
    int code = http.PUT("\"" + activeUid + "\"");
    http.end();
    if (code == 200) {
        Serial.printf("[CLOUD] Kode klaim: %s\n", claimCode.c_str());

        Preferences prefs;
        prefs.begin("shc", false);
        prefs.putBool("claimDone", true);
        prefs.end();
        return true;
    }
    Serial.printf("[CLOUD] Gagal publikasi kode klaim (HTTP %d).\n", code);
    return false;
}

static void cloudTask(void*) {
    char lastState[20] = "";
    uint32_t lastPushMs = 0;
    uint32_t lastPollMs = 0;
    uint32_t lastSessMs = 0;
    // Satu TLS untuk semua request. Sebelumnya tiap request membuat client baru:
    // handshake 1-3 dtk, dan satu siklus (push + config + session) membayarnya
    // tiga kali. Itu lag utama yang dirasakan di web dan aplikasi.
    WiFiClientSecure tls;
    tls.setInsecure();
    tls.setTimeout(8);
    // Satu HTTPClient untuk semua request RTDB. Destruktor HTTPClient memanggil
    // client->stop(), jadi objek ini harus hidup selama loop, bukan per blok.
    HTTPClient rtdb;
    rtdb.setReuse(true);
    rtdb.setTimeout(8000);
    float lastWeightG = -999, lastTempC = -999, lastHumPct = -999, lastTargetMin = -1;
    uint16_t lastDrinkCnt = 0xFFFF, lastRefillCnt = 0xFFFF, lastCheatCnt = 0xFFFF;
    bool lastMuted = false;
    bool lastStandby = false;
    uint16_t hbCounter = 0;
    uint8_t cfgPatchFails = 0;

    for (;;) {
        if (activeFirebaseUrl.length() == 0 || WiFi.status() != WL_CONNECTED) {
            // Tanpa baris ini, Wi-Fi yang gagal terhubung terlihat identik dengan
            // login yang gagal: cloudTask hanya diam. Cetak sesekali saja.
            static uint32_t lastWifiLogMs = 0;
            if ((uint32_t)(millis() - lastWifiLogMs) > 10000UL) {
                lastWifiLogMs = millis();
                if (activeFirebaseUrl.length() == 0) {
                    Serial.println(F("[CLOUD] URL Firebase kosong: periksa secrets.h "
                                     "(FIREBASE_DB_URL)."));
                } else if (WiFi.status() != WL_CONNECTED) {
                    Serial.printf("[CLOUD] Wi-Fi belum konek (status %d, SSID \"%s\"). "
                                  "Periksa sandi dan pastikan SSID 2.4 GHz; "
                                  "status 6 hanya berarti terputus.\n",
                                  (int)WiFi.status(), activeWifiSsid.c_str());
                }
            }
            vTaskDelay(pdMS_TO_TICKS(2000));
            continue;
        }
        // Sekali saja: bukti asosiasi Wi-Fi benar-benar selesai, bukan sekadar
        // WiFi.begin() dipanggil.
        static bool connectedLogged = false;
        if (!connectedLogged) {
            connectedLogged = true;
            Serial.printf("[CLOUD] Wi-Fi tersambung, IP %s\n",
                          WiFi.localIP().toString().c_str());
        }
        if (!ensureToken()) {
            vTaskDelay(pdMS_TO_TICKS(30000));
            continue;
        }

        uint32_t now = millis();
        CloudSnapshot local;
        portENTER_CRITICAL(&snapMux);
        local = snap;
        portEXIT_CRITICAL(&snapMux);

        // Salinan kode di akun pemilik, terpisah dari /claims. /claims hanya
        // boleh dibaca pemilik dan menolak PUT kedua selamanya, jadi node ini
        // yang dipakai tombol "Cari alat" di halaman Akun.
        if (!claimMirrorChecked && claimMirrored &&
            (int32_t)(now - mirrorRetryAfterMs) >= 0) {
            String cek = activeFirebaseUrl + "/users/" + activeUid +
                         "/smart_coaster/claimCode.json" + authSuffix();
            bool cekOk = false;
            if (rtdb.begin(tls, cek)) {
                int cekCode = rtdb.GET();
                String isi = (cekCode == 200) ? rtdb.getString() : String();
                rtdb.end();
                if (cekCode == 200) {
                    cekOk = true;
                    claimMirrorChecked = true;
                    if (isi.indexOf(claimCode) < 0) {
                        // Node dihapus, atau akun berganti sementara NVS masih
                        // menyimpan tanda lama. Buka gerbang dan tulis ulang.
                        claimMirrored = false;
                        Preferences mp;
                        mp.begin("shc", false);
                        mp.remove("claimMirrorDone");
                        mp.end();
                        Serial.println(F("[CLOUD] Salinan kode tidak cocok; ditulis ulang."));
                    }
                }
            }
            // Gagal baca jangan diulang tiap 250 ms; mundur satu jam seperti PUT.
            if (!cekOk) mirrorRetryAfterMs = now + 3600000UL;
        }

        if (!claimMirrored && (int32_t)(now - mirrorRetryAfterMs) >= 0) {
            String mine = activeFirebaseUrl + "/users/" + activeUid +
                          "/smart_coaster/claimCode.json" + authSuffix();
            if (rtdb.begin(tls, mine)) {
                rtdb.addHeader("Content-Type", "application/json");
                int mirrorCode = rtdb.PUT("\"" + claimCode + "\"");
                rtdb.end();
                if (mirrorCode == 200) {
                    claimMirrored = true;
                    // Bukti yang bisa dibaca dari Serial. Tanpa ini, berhasil dan
                    // belum-dicoba terlihat sama.
                    Serial.printf("[CLOUD] Salinan kode klaim tersimpan (HTTP 200).\n");
                    Preferences mp;
                    mp.begin("shc", false);
                    mp.putBool("claimMirrorDone", true);
                    mp.end();
                } else {
                    // 401 = aturan claimCode belum dipasang di konsol.
                    // Cetak sekali per jam, jangan tiap putaran cloudTask.
                    mirrorRetryAfterMs = now + 3600000UL;
                    Serial.printf("[CLOUD] Salinan kode klaim gagal (HTTP %d). Pasang aturan claimCode, atau baca kode dari sini.\n", mirrorCode);
                }
            }
        }

        if (!claimPublished && (int32_t)(now - claimRetryAfterMs) >= 0) {
            // Aturan RTDB menolak PUT kedua selamanya. Gagal sekali = jangan
            // coba lagi tiap 250 ms; mundur satu jam.
            claimPublished = publishClaimCode();
            if (!claimPublished) claimRetryAfterMs = now + 3600000UL;
        }

        bool stateChanged = strncmp(local.stateStr, lastState, sizeof(lastState)) != 0;
        // Push hanya saat isi berubah. Sebelumnya ada push buta tiap 5 dtk yang
        // menulis ulang angka yang sama: kuota terpakai, dan web/aplikasi tetap
        // menunggu jeda poll-nya sendiri. Pembanding mencakup semua field yang
        // dikirim, kecuali remaining_sec yang memang berjalan terus.
        bool dataChanged =
            stateChanged ||
            fabsf(local.weightG - lastWeightG) > 0.5f ||
            local.drinkCnt != lastDrinkCnt ||
            local.refillCnt != lastRefillCnt ||
            local.cheatCnt != lastCheatCnt ||
            local.muted != lastMuted ||
            fabsf(local.targetMin - lastTargetMin) > 0.01f ||
            fabsf(local.tempC - lastTempC) > 0.2f ||
            fabsf(local.humPct - lastHumPct) > 1.0f ||
            // Perpindahan sesi harus terkirim saat itu juga. Kalau alat sudah IDLE
            // saat sesi ditutup, state-nya tidak berubah, jadi tanpa pembanding ini
            // klien baru tahu alat tidur dari heartbeat 60 dtk.
            local.standby != lastStandby;
        // Heartbeat 60 dtk: penanda hidup, bukan data. Klien bisa membedakan
        // "alat diam" dari "alat mati" tanpa membandingkan nilai yang identik.
        bool heartbeat = (now - lastPushMs >= 60000UL);
        if (dataChanged || heartbeat) {
            strncpy(lastState, local.stateStr, sizeof(lastState) - 1);
            lastState[sizeof(lastState) - 1] = '\0';
            lastWeightG = local.weightG;
            lastDrinkCnt = local.drinkCnt;
            lastRefillCnt = local.refillCnt;
            lastCheatCnt = local.cheatCnt;
            lastMuted = local.muted;
            lastTargetMin = local.targetMin;
            lastTempC = local.tempC;
            lastHumPct = local.humPct;
            lastStandby = local.standby;
            lastPushMs = now;

            String url = userNode() + "/telemetry.json" + authSuffix();
            if (rtdb.begin(tls, url)) {
                rtdb.addHeader("Content-Type", "application/json");
                char body[400];
                snprintf(body, sizeof(body),
                    "{\"weight_g\":%.1f,\"water_ml\":%.1f,\"temp_c\":%.1f,\"humidity_pct\":%.0f,"
                    "\"fsm_state\":\"%s\",\"remaining_sec\":%lu,\"target_interval_min\":%.2f,"
                    "\"total_ml\":%.1f,\"drink_count\":%u,\"refill_count\":%u,\"cheat_count\":%u,"
                    "\"muted\":%s,\"standby\":%s,\"hb\":%u}",
                    local.weightG, local.waterMl, local.tempC, local.humPct,
                    local.stateStr, (unsigned long)local.remSec, local.targetMin,
                    local.totalMl, local.drinkCnt, local.refillCnt, local.cheatCnt,
                    local.muted ? "true" : "false", local.standby ? "true" : "false",
                    (unsigned)(++hbCounter));
                rtdb.PATCH((uint8_t*)body, strlen(body));
                rtdb.end();
            }
        }

        // Unggah perubahan lokal lebih dulu, supaya GET berikutnya sudah membaca
        // nilai yang benar. Yang menentukan adalah gerbang if (!configDirty) di
        // blok apply: tanpa gerbang itu, perintah serial yang jatuh saat GET
        // berjalan akan tertimpa nilai cloud lama dan NVS-nya ikut ditulis basi.
        if (configDirty) {
            configDirty = false;
            bool patchOk = false;
            String cfgUrl = userNode() + "/config.json" + authSuffix();
            if (rtdb.begin(tls, cfgUrl)) {
                rtdb.addHeader("Content-Type", "application/json");
                char cfgBody[160];
                // Demo harus ikut ditulis. Tanpa ini, perintah serial apa pun yang
                // mengubah config lokal membuat alat mem-PATCH AUTO_DHT/MANUAL dan
                // pilihan DEMO milik klien ikut terhapus.
                const char* modeStr =
                    demoMode ? "DEMO" : (autoDhtTimerMode ? "AUTO_DHT" : "MANUAL");
                snprintf(cfgBody, sizeof(cfgBody),
                    "{\"timer_mode\":\"%s\",\"manual_interval_min\":%lu,"
                    "\"muted\":%s,\"empty_cup_weight_g\":%.1f}",
                    modeStr,
                    (unsigned long)(customBaseIntervalMs / 60000UL),
                    buzzerMuted ? "true" : "false",
                    fsm.getEmptyCupWeight());
                int code = rtdb.PATCH((uint8_t*)cfgBody, strlen(cfgBody));
                patchOk = (code >= 200 && code < 300);
                rtdb.end();
            }
            // PATCH gagal: pasang lagi flag-nya supaya nilai lokal tidak hilang
            // pada GET berikutnya, tetapi beri jeda agar jaringan mati tidak
            // memicu PATCH beruntun tiap 250 ms.
            if (!patchOk) {
                if (cfgPatchFails < 3) {
                    cfgPatchFails++;
                    configDirty = true;
                    vTaskDelay(pdMS_TO_TICKS(1500));
                } else {
                    cfgPatchFails = 0;
                }
            } else {
                cfgPatchFails = 0;
            }
        }

        // 1 dtk: config adalah perintah (saklar mute, mode timer). Ini setengah
        // dari anggaran latensi kontrol, dan dengan TLS yang dipakai ulang biayanya
        // hanya satu GET kecil. Sebelumnya 15 dtk, lalu 3 dtk — keduanya masih
        // terasa mati dibanding SSE di sisi klien.
        if (now - lastPollMs >= 1000UL) {
            lastPollMs = now;
            String url = userNode() + "/config.json" + authSuffix();
            if (rtdb.begin(tls, url) && rtdb.GET() == 200) {
                String cfg = rtdb.getString();
                // Perintah serial lokal (q/m/i/e/c) bisa jatuh selama GET ini
                // berjalan (1-3 dtk). Saat itu nilai cloud yang baru dibaca basi:
                // lewati penerapan seluruhnya, biarkan flag terpasang supaya tick
                // berikut mengunggah nilai lokal. Tanpa gerbang ini, setelan lokal
                // tertimpa nilai lama dan NVS-nya ikut ditulis basi.
                if (!configDirty) {
                    bool changed = false;
                    // Tiga nilai: DEMO (15 dtk, tanpa kompensasi DHT), AUTO_DHT,
                    // MANUAL. Nilai DEMO dulu hanya hidup sebagai perintah serial,
                    // sehingga pemilihan dari web atau aplikasi tidak berpengaruh
                    // saat alat dijangkau lewat cloud.
                    bool wantDemo = cfg.indexOf("\"DEMO\"") >= 0;
                    bool wantAuto = cfg.indexOf("\"AUTO_DHT\"") >= 0;
                    if (wantDemo != demoMode) { demoMode = wantDemo; changed = true; }
                    // Dalam mode demo, tombol DHT tidak berlaku: targetnya tetap
                    // 15 dtk. Nilainya hanya disimpan supaya kembali apa adanya
                    // begitu pengguna keluar dari mode demo.
                    if (!wantDemo && wantAuto != autoDhtTimerMode) {
                        autoDhtTimerMode = wantAuto;
                        changed = true;
                    }
                    float mins = extractJsonFloat(cfg, "\"manual_interval_min\"", 0.0f);
                    if (mins >= MIN_CUSTOM_INTERVAL_MIN && mins <= MAX_CUSTOM_INTERVAL_MIN) {
                        uint32_t newBase = (uint32_t)(mins * 60000.0f);
                        if (newBase != customBaseIntervalMs) {
                            customBaseIntervalMs = newBase;
                            changed = true;
                        }
                    }
                    float emptyG = extractJsonFloat(cfg, "\"empty_cup_weight_g\"", 0.0f);
                    if (emptyG >= CUP_ON_THRESHOLD && emptyG <= MAX_EMPTY_CUP_G &&
                        fabs(emptyG - fsm.getEmptyCupWeight()) > 0.5f) {
                        fsm.setEmptyCupWeight(emptyG);
                        changed = true;
                    }
                    if (changed) {
                        updateAdaptiveInterval();
                        saveConfigToNvs();
                        configDirty = false;
                        // Tidak perlu memaksa push: muted dan targetMin ikut
                        // dataChanged, jadi tick berikut mengirimnya sendiri.
                    }
                }
            }
            rtdb.end();

            // Sesi bergiliran: web menulis session.owner. Begitu nilainya berbeda dari
            // pemilik terakhir, statistik di-reset supaya orang berikutnya tidak
            // mewarisi angka orang sebelumnya. Node ini juga membawa active:false,
            // jadi periode poll menentukan secepat apa alarm berhenti setelah
            // pengguna menekan Akhiri Sesi.
            //
            // 1 dtk hanya saat alarm menyala atau alat sedang tidur: di dua keadaan
            // itu keterlambatan terasa (buzzer masih berbunyi, atau tombol Mulai
            // Sesi tampak tidak bekerja). Di luar itu pemilik sesi jarang berubah,
            // jadi 10 dtk sudah cukup dan kuota lebih hemat.
            bool alertNow = strncmp(local.stateStr, "ALERT_", 6) == 0;
            uint32_t sessPeriodMs = (local.standby || alertNow) ? 1000UL : 10000UL;
            if (now - lastSessMs >= sessPeriodMs) {
            lastSessMs = now;
            String sessUrl = userNode() + "/session.json" + authSuffix();
            if (rtdb.begin(tls, sessUrl) && rtdb.GET() == 200) {
                String sess = rtdb.getString();
                // "active":false = pengguna menekan Akhiri Sesi. Field ini tidak
                // ada di versi lama, dan ketiadaannya berarti sesi masih aktif.
                // Nilai cloud hanya menimpa perintah lokal z/x saat nilainya
                // berubah; lihat SessionGate di session_gate.h.
                bool wantSleep = sess.indexOf("\"active\":false") >= 0;
                portENTER_CRITICAL(&snapMux);
                sessionGate.fromCloud(wantSleep);
                portEXIT_CRITICAL(&snapMux);
                int oi = sess.indexOf("\"owner\":\"");
                if (oi >= 0) {
                    oi += 9;
                    int oe = sess.indexOf('"', oi);
                    if (oe > oi) {
                        String owner = sess.substring(oi, oe);
                        if (owner.length() > 0 && strncmp(owner.c_str(), sessionOwner, sizeof(sessionOwner)) != 0) {
                            strncpy(sessionOwner, owner.c_str(), sizeof(sessionOwner) - 1);
                            sessionOwner[sizeof(sessionOwner) - 1] = '\0';
                            Preferences sp;
                            sp.begin("shc", false);
                            sp.putString("sessionOwner", sessionOwner);
                            sp.end();
                            fsm.resetDailyStats();
                            saveStatsToNvs();
                            Serial.printf("[CLOUD] Sesi baru untuk %.8s..., statistik di-reset.\n", owner.c_str());
                        }
                    }
                }
            }
            rtdb.end();
            }
        }

        vTaskDelay(pdMS_TO_TICKS(250));
    }
}

// Portal tangkap: buka AP sendiri, jadi SSID tidak perlu diketik satu per satu
// lewat Serial Monitor. Dipakai hanya saat kredensial kosong atau sambungan gagal
// 20 dtk; pemakaian normal tidak terganggu. Nilai portal ditulis ke NVS dengan
// kunci yang sama seperti perintah serial `w`, supaya kedua jalur tidak menimpa.
static String wifiPortalSsid, wifiPortalPass;

// Bila kredensial tersimpan tidak lagi berlaku (router pindah atau sandi
// berganti), alat akan diam tanpa portal sampai dicolok USB. Deteksi lewat
// waktu, bukan lewat penantian yang memblokir: setelah 30 dtk gagal konek,
// portal dibuka dan pengguna bisa memperbaiki dari ponsel.
static uint32_t wifiAttemptMs = 0;
static bool portalConnected = false;

static void wifiOnSaveParams() {
    if (wifiPortalSsid.length() == 0) return;
    activeWifiSsid = wifiPortalSsid;
    activeWifiPass = wifiPortalPass;
    Preferences p;
    p.begin("shc", false);
    p.putString("wifiSsid", wifiPortalSsid);
    p.putString("wifiPass", wifiPortalPass);
    p.end();
    Serial.printf("[WIFI] Portal menyimpan SSID \"%s\"\n", wifiPortalSsid.c_str());
    // Portal tidak memanggil WiFi.begin() sendiri di mode non-blocking. Tanpa
    // baris ini, portal hanya ditutup lalu dibuka lagi: alat tidak pernah
    // mencoba kredensial yang baru disimpan.
    portalConnected = true;
    WiFi.mode(WIFI_STA);
    WiFi.begin(activeWifiSsid.c_str(), activeWifiPass.c_str());
    wifiAttemptMs = millis();
}

// Portal dibuka tanpa memblokir: autoConnect() (tidak dipakai di sini) menahan core 1 sampai 180 dtk,
// dan selama itu sampling 10 Hz serta gerbang stabilitas 1,5 dtk berhenti.
// handleWifiPortal() dipanggil dari loop() dan hanya memproses satu putaran
// server, jadi alat tetap mengukur sambil menunggu kredensial.
static WiFiManager wifiMgr;
static bool portalActive = false;
static uint32_t portalStartedMs = 0;

// mDNS: alat mengumumkan dirinya sendiri di LAN sebagai "<Kode>._shc._tcp"
// beserta teks "code=<Kode>". Aplikasi Firebase Android (NsdManager) atau
// iOS (NWBrowser) menemukannya tanpa Serial Monitor dan tanpa mengetik
// apa pun. Didaftarkan sekali sejak boot, jadi namanya tetap sama meski
// portal dibuka berulang kali.

inline void startClaimBeacon() {
    if (claimCode.length() == 0) return;
    if (!MDNS.begin(claimCode.c_str())) {
        Serial.println(F("[MDNS] Gagal mulai; klaim lewat portal tetap jalan."));
        return;
    }
    // Portal hidup dalam mode AP saja. Di mode itu antarmuka STA tidak aktif,
    // dan WiFi.macAddress() mengembalikan 00:00:00:00:00:00. MAC dibaca dari
    // eFuse supaya TXT tetap berisi alamat perangkat untuk aplikasi Android/iOS.
    uint8_t macBin[6];
    char macTxt[18];
    esp_efuse_mac_get_default(macBin);
    snprintf(macTxt, sizeof(macTxt), "%02X:%02X:%02X:%02X:%02X:%02X",
             macBin[0], macBin[1], macBin[2], macBin[3], macBin[4], macBin[5]);
    MDNS.addService("shc", "tcp", 80);
    MDNS.addServiceTxt("shc", "tcp", "code", claimCode);
    MDNS.addServiceTxt("shc", "tcp", "mac", String(macTxt));
    Serial.printf("[MDNS] Dapat ditemukan di LAN: %s._shc._tcp, code=%s, mac=%s\n",
                  claimCode.c_str(), claimCode.c_str(), macTxt);
}

inline void stopClaimBeacon() {
    MDNS.end();
}

inline void startWifiPortal(bool force) {
    if (portalActive) return;
    wifiMgr.setConfigPortalBlocking(false);
    // Batas waktu tidak berlaku di mode non-blocking; batasnya dijaga sendiri
    // lewat portalStartedMs di handleWifiPortal().
    wifiMgr.setConnectTimeout(20);
    static WiFiManagerParameter pSsid("ssid", "Nama Wi-Fi (2.4 GHz)", "", 33);
    static WiFiManagerParameter pPass("pass", "Kata sandi", "", 65);
    // Didaftarkan sekali saja: addParameter menumpuk, dan portal yang dibuka
    // berulang kali akan menampilkan field ganda.
    static bool paramsAdded = false;
    if (!paramsAdded) {
        paramsAdded = true;
        wifiMgr.addParameter(&pSsid);
        wifiMgr.addParameter(&pPass);
    }
    wifiMgr.setSaveParamsCallback([&]() {
        wifiPortalSsid = pSsid.getValue();
        wifiPortalPass = pPass.getValue();
        wifiOnSaveParams();
    });
    Serial.printf("[WIFI] Portal dibuka. Sambungkan ponsel ke Wi-Fi \"%s\" "
                  "(sandi: %s), lalu isi nama dan sandi jaringan rumah.\n",
                  PORTAL_AP_NAME, PORTAL_AP_PASS);
    wifiMgr.startConfigPortal(PORTAL_AP_NAME, PORTAL_AP_PASS);
    portalActive = true;
    portalStartedMs = millis();
    startClaimBeacon();
}

// Dipanggil dari loop() core 1. Mengembalikan true bila portal masih terbuka.

inline void checkWifiStale() {
    if (portalActive) return;
    // Kredensial baru dari portal masih dicoba: beri waktu sebelum menilai gagal.
    if (portalConnected) {
        if (WiFi.status() == WL_CONNECTED) { portalConnected = false; wifiAttemptMs = 0; return; }
        if (millis() - wifiAttemptMs < 30000UL) return;
        portalConnected = false;
    }
    if (activeWifiSsid.length() == 0) return;
    if (WiFi.status() == WL_CONNECTED) { wifiAttemptMs = 0; return; }
    if (wifiAttemptMs == 0) { wifiAttemptMs = millis(); return; }
    if (millis() - wifiAttemptMs > 30000UL) {
        Serial.println(F("[WIFI] Gagal tersambung 30 dtk: membuka portal."));
        wifiAttemptMs = 0;
        startWifiPortal(true);
    }
}

inline bool handleWifiPortal() {
    if (!portalActive) return false;
    wifiMgr.process();
    if (WiFi.status() == WL_CONNECTED && activeWifiSsid.length() > 0) {
        portalActive = false;
        stopClaimBeacon();
        Serial.printf("[WIFI] Tersambung ke \"%s\"\n", activeWifiSsid.c_str());
        return false;
    }
    if (millis() - portalStartedMs > 180000UL) {
        portalActive = false;
        stopClaimBeacon();
        wifiMgr.stopConfigPortal();
        WiFi.mode(WIFI_STA);
        Serial.println(F("[WIFI] Portal ditutup tanpa kredensial. Kirim 'w<SSID>|<sandi>' "
                         "lewat serial atau nyalakan ulang."));
        return false;
    }
    return true;
}

inline bool wifiPortalIsOpen() { return portalActive; }

inline void startCloudIfNeeded() {
    if (activeWifiSsid.length() == 0) {
        Serial.println(F("[CLOUD] SSID kosong: membuka portal Wi-Fi."));
        startWifiPortal(true);
    } else if (!portalActive) {
        WiFi.mode(WIFI_STA);
        WiFi.begin(activeWifiSsid.c_str(), activeWifiPass.c_str());
        wifiAttemptMs = millis();
        Serial.printf("[CLOUD] Menghubungkan Wi-Fi \"%s\"...\n", activeWifiSsid.c_str());
    }
    if (activeFirebaseUrl.length() == 0) {
        Serial.println(F("[CLOUD] URL Firebase kosong: cloud tidak dijalankan. "
                         "Periksa FIREBASE_DB_URL di secrets.h."));
        return;
    }
    if (!cloudTaskRunning) {
        cloudTaskRunning = true;
        xTaskCreatePinnedToCore(cloudTask, "cloudSync", 8192, nullptr, 1, nullptr, 0);
    }
}

inline void initCloudSync(const String& nvsSsid, const String& nvsPass, const String& nvsUrl) {
    if (nvsSsid.length() > 0) {
        activeWifiSsid = nvsSsid;
        activeWifiPass = nvsPass;
    }
    if (nvsUrl.length() > 0) {
        activeFirebaseUrl = nvsUrl;
    }
    Preferences prefs;
    prefs.begin("shc", true);
    idToken = prefs.getString("idToken", "");
    activeUid = prefs.getString("uid", "");
    refreshToken = prefs.getString("refreshToken", "");
    claimCode = prefs.getString("claimCode", "");
    // NVS: tanpa ini sessionOwner kembali kosong tiap boot, RTDB masih menyimpan
    // pemilik lama, dan resetDailyStats() jalan setiap reboot (data harian hilang).
    String savedOwner = prefs.getString("sessionOwner", "");
    strncpy(sessionOwner, savedOwner.c_str(), sizeof(sessionOwner) - 1);
    sessionOwner[sizeof(sessionOwner) - 1] = '\0';
    // Aturan RTDB menolak penulisan kode klaim kedua; setelah berhasil sekali,
    // jangan PUT lagi (dulu retry 250 ms terus dan membakar kuota).
    claimPublished = prefs.getBool("claimDone", false);
    // Salinan di node pemilik bukan bagian dari /claims: aturan di sana
    // tidak melarang PUT ulang. Tandai terpisah supaya alat yang sudah
    // pernah mengklaim tetap menyalin kodenya setelah firmware ini naik.
    claimMirrored = prefs.getBool("claimMirrorDone", false);
    // Statusnya dicetak: bila gerbang sudah tertutup, blok salinan tidak jalan
    // dan tidak ada baris PUT sama sekali. Tanpa baris ini, "sudah tersimpan"
    // dan "tidak pernah dicoba" tidak bisa dibedakan dari Serial.
    Serial.printf("[CLOUD] Salinan kode klaim: %s\n",
                  claimMirrored ? "sudah tercatat, PUT tidak diulang"
                                : "belum tercatat, akan dicoba");
    if (claimCode.length() == 0) {
        claimCode = makeClaimCode();
        Preferences w;
        w.begin("shc", false);
        w.putString("claimCode", claimCode);
        w.end();
    }
    // millis() ulang dari nol setiap boot, jadi cap kedaluwarsa dari boot sebelumnya
    // tidak bisa dipercaya. Set 0 supaya ensureToken() memaksa perpanjangan/login awal.
    tokenExpiryMs = 0;
    prefs.end();
    Serial.printf("[CLOUD] Kode klaim alat: %s\n", claimCode.c_str());
    // Ringkasan konfigurasi SEBELUM Wi-Fi dicoba. Tanpa ini, secrets.h yang tidak
    // ikut ter-compile terlihat identik dengan Wi-Fi gagal: cloudTask tidak pernah
    // dibuat, jadi tidak ada satu pun baris [CLOUD] sesudah boot.
    Serial.printf("[CLOUD] Konfigurasi: ssid=%u url=%u key=%u email=%u\n",
                  (unsigned)activeWifiSsid.length(), (unsigned)activeFirebaseUrl.length(),
                  (unsigned)activeApiKey.length(), (unsigned)activeUserEmail.length());
    startCloudIfNeeded();
}

inline void setCloudWifi(const String& ssid, const String& pass) {
    activeWifiSsid = ssid;
    activeWifiPass = pass;
    WiFi.disconnect();
    startCloudIfNeeded();
}

inline void setCloudFirebaseUrl(const String& url) {
    activeFirebaseUrl = url;
    startCloudIfNeeded();
}

inline void updateCloudSnapshot(float w, uint32_t nowMs, float tC, float hum, bool muted) {
    if (!cloudTaskRunning) return;
    portENTER_CRITICAL(&snapMux);
    snap.weightG = w;
    snap.waterMl = fsm.getWaterVolumeMl(w);
    snap.tempC = tC;
    snap.humPct = hum;
    strncpy(snap.stateStr, fsm.getStateString(), sizeof(snap.stateStr) - 1);
    snap.remSec = fsm.getRemainingTimeMs(nowMs) / 1000;
    snap.targetMin = fsm.getTargetIntervalMs() / 60000.0f;
    snap.totalMl = fsm.getTotalDrank();
    snap.drinkCnt = fsm.getDrinkCount();
    snap.refillCnt = fsm.getRefillCount();
    snap.cheatCnt = fsm.getCheatCount();
    snap.muted = muted;
    snap.standby = sessionGate.sleep;
    portEXIT_CRITICAL(&snapMux);
}
#else
inline void initCloudSync(const String&, const String&, const String&) {}
inline void setCloudWifi(const String&, const String&) {}
inline void setCloudFirebaseUrl(const String&) {}
inline void updateCloudSnapshot(float, uint32_t, float, float, bool) {}
inline void setLocalStandby(bool) {}
inline bool standbyActiveNow() { return false; }
#endif

#endif
