WindraNatan/Coaster/(commit log)

2026-10-09 snapshot: sebelum fix celah 1 dan 2
    [SmartHydrationCoaster.ino, adaptive_controller.h, config.h, filter.h, fsm.h, kalibrasi.ino, test_hardware.ino]
2026-10-21 checkpoint: pangkas temuan audit + antislop-code
    - filter.h ditulis ulang 55 -> 25 baris; ekuivalen output terverifikasi
    (772 byte identik, 4 fase LCG deterministik, 0 warning -Wall -Wextra)
    - 26 banner komentar // ==== dibuang (casing_3d.html 20, coaster_casing.scad 6);
    judul seksi bernomor dipertahankan, render STL front/rear/lid identik byte-size
    - snap.dirty dibuang dari cloud_sync.h
    - 14 file arsip dipindah keluar (_arsip/, logo-brand, png render)
    - angka doc dikoreksi ke hasil verifikasi: Python 21, C++ 52, JS 30 asersi
    (4 skenario K1/K3), CAD 59
    - 4 suite lulus: C++ 52/52, JS, Python, CAD 59/59
    [coaster_casing.scad, coaster_casing.stl, coaster_casing_chassis.stl, front.stl, lid.stl, rear.stl]
2026-10-21 doc: perbaiki premis usang uji web di audit
    Kelas FSM sudah diekstrak ke web/fsm.js dan diimpor index.html lewat
    script src=fsm.js, dengan web/fsm.test.js (30 asersi, 4 skenario K1/K3).
    Klaim tertanam di dalam HTML / tidak bisa diimpor Node dan 6.6 KB kode
    inline sudah tidak benar.
2026-10-22 fix: mirror CAD layout and USB evidence
    [coaster_casing.scad, coaster_casing.stl, front.stl, lid.stl, rear.stl]
2026-10-22 fix: kembalikan sumbu x CAD ke patokan HTML (revert mirror USB)
    Commit 467cd56 menegasikan semua x di coaster_casing.scad tanpa bukti fisik
    baru. Audit pra-mirror sendiri menyatakan grid perfboard "dipakai bersama
    oleh SCAD dan HTML" (x = -21.59 + 2.54k, byte-identik) dan menutup temuan
    "SCAD dan HTML tidak konsisten" dengan angka yang sama di kedua file.
    HTML tidak punya transform mirror (tanpa scale/rotasi grup; hanya 2
    rotation.z pada baut preview), jadi HTML.x == SCAD.x. Setelah mirror, slot
    USB jadi 10,16 mm dari port ESP32 di HTML (usb_x -5.08 vs ESP_X 5.08) dan
    lima posisi modul pindah kolom grid.
    Laporan "port HTML di kanan, SCAD di kiri" adalah artefak arah pandang:
    render rear di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
    [coaster_casing.scad, coaster_casing.stl, front.stl, lid.stl, rear.stl]
2026-10-22 Revert "fix: kembalikan sumbu x CAD ke patokan HTML (revert mirror USB)"
    This reverts commit 25d460e45ce20931f616bc6e5c37cff183b7f281.
    [coaster_casing.scad, coaster_casing.stl, front.stl, lid.stl, rear.stl]
2026-10-22 doc: pisahkan 7 state enum dari 9 string wire, ALERT_REFILL kirim EMPTY/MISSING
2026-10-23 fix: perpanjang token otomatis dan reset cap kedaluwarsa saat boot
    Token Firebase cuma berlaku satu jam. Web dan aplikasi kini menyimpan
    refreshToken dan menukarnya tanpa minta password lagi. Firmware juga
    menyimpan refreshToken di NVS. Cap kedaluwarsa di-reset ke nol setiap boot
    karena millis() kembali ke nol, jadi nilai dari boot sebelumnya tidak sah.
    [cloud_sync.h]
2026-10-23 fix: kredensial lewat secrets.h, jangan taruh di repo publik
    [config.h]
2026-10-23 feat: klaim alat lewat kode dan sesi bergiliran
    Perangkat membuat kode 8 karakter sekali, menyimpannya di NVS, dan menulisnya ke
    /claims/<kode> supaya pemilik bisa menautkan alat ke akunnya. Rules menolak
    penulisan tautan kecuali kode menunjuk ke perangkat yang dimaksud, dan menolak
    sesi atas nama orang lain.
    Web: tombol Klaim Alat, dan Mulai/Akhiri Sesi. Perangkat mem-poll session.json
    lalu me-reset statistiknya saat pemilik berganti, jadi tiap orang mulai dari nol.
    Juga: default demoMode jadi false, dan poll web hanya menarik telemetry+config
    supaya riwayat harian tidak membanjiri kuota RTDB.
    [SmartHydrationCoaster.ino, cloud_sync.h]
2026-10-23 refactor: rapikan caption footer web dan satukan format rentang di app
2026-10-25 fix(firmware): pulihkan kompilasi dan hentikan kehilangan data cloud
    Firmware tidak pernah bisa dikompilasi dari repo: cloud_sync.h memanggil
    saveStatsToNvs() tanpa deklarasi extern.
    - deklarasikan saveStatsToNvs() (extern) -- ini yang menggagalkan build
    - simpan sessionOwner ke NVS: dulu setiap reboot dianggap pemilik baru dan
    resetDailyStats() menghapus angka harian
    - baca claimDone saat init + backoff 1 jam: aturan RTDB menolak PUT klaim
    kedua selamanya, dulu retry tiap 250 ms (~345 rb request ditolak/hari)
    - jsonEscape() untuk kutip, backslash, dan karakter kontrol pada body login
    - hapus dua tulis idTokenExp yang tidak pernah dibaca
    Verifikasi: arduino-cli compile esp32:esp32:esp3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
    [cloud_sync.h]
2026-10-25 feat(app): tambahkan proyek Flutter mode Cloud dan perbaiki jalur error
    Sebelum ini app/ hanya berisi README, auth.dart, main.dart, dan satu test;
    pubspec, android/, assets/, telemetry.dart, dan test sisanya tidak terlacak,
    jadi proyeknya tidak bisa di-build dari clone bersih.
    - lacak pubspec, pubspec.lock, analysis_options, android/, assets/fonts,
    telemetry.dart, telemetry_test.dart
    - _poll(): tampilkan error asli lebih dulu, lalu coba perpanjang token di
    try/catch sendiri dan teruskan _client. Sebelumnya kegagalan refresh
    (MissingPluginException di test, jaringan putus di perangkat) menelan
    penyebab sebenarnya dan dashboard membeku tanpa pesan
    - label kartu "TOTAL HARI INI" -> "TO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
2026-10-29 fix(cad): arahkan pin modul motor ke header pendatar
    Pin modul motor digambar keluar ke -x, padahal header-nya di x 21.59.
    Kabel jadi harus menyeberang papan 41 mm. Sekarang keluar ke +x: ujung pin
    di 13.42 mm, jarak ke header 8.17 mm, masih di dalam rongga (batas 27).
    Verifikasi: openscad render sukses, verify_stackup.py 59/59.
    [coaster_casing.scad]
2026-10-29 docs(rakit): ganti panduan jumper jadi sambungan hybrid
    Panduan 3D menampilkan enam langkah metode lama (header male + jumper).
    Sekarang mengikuti cara yang benar-benar dipakai: kabel disolder permanen
    ke papan, konektor female di ujung modul supaya sensor bisa dicabut.
    Kabel timbangan tetap disolder di kedua ujung karena konektor membuat
    bacaan berat melayang.
    - STEP_DATA ditulis ulang: 6 langkah, tiap langkah menyebut tipe kabel
    - titik solder disebut dengan label cetakan papan (A10, D07, M01, Q02),
    bukan koordinat; arah cetakan PY-5CM*7CM: angka 01 di kanan, A di bawah
    - legenda kabel: istilah teknis diganti bahasa sehari-hari
    - semua teks sisi memakai frame fisik (buzzer = strip kanan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
2026-10-29 docs: sisir sisa istilah jumper dan betulkan angka komentar
    Panduan sudah pindah ke sambungan hybrid, tapi 20 komentar di cad/ dan
    web/ masih menyebut "jumper female-female" dan "header pendarat jumper".
    Sekarang seragam: titik solder di papan, konektor female di ujung modul.
    - komentar arah pin motor tidak lagi bertentangan (+x di dua tempat)
    - jarak kabel dibetulkan: ujung pin 13.42 -> header 21.59 = 8.17 mm;
    kalau dibalik ke -x jadi 45.17 mm (dulu ditulis 11.7 dan 41)
    - CLAUDE.md: titik solder motor (21.59, 96.81) ditambahkan
    - AUDIT_DESIGN_3D.md: "empat header pendarat jumper" -> "empat titik solder"
    Verifikasi: openscad render bersih, verify_stackup.py 59/59,
    test_simulation.py dan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
    [coaster_casing.scad]
2026-10-29 test(cad): kunci arah pin motor agar tidak diam-diam terbalik
    check "motor di dalam tutup" memakai abs(mtr_x), jadi lolos untuk kedua
    arah pin. Itu sebabnya pin yang menghadap -x lolos 59/59 kemarin.
    Check baru membaca baris translate() di SCAD, bukan menghitung ulang rumus
    yang sama, lalu gagal kalau tandanya negatif. Diverifikasi dengan
    menyuntikkan bug: pin dibalik -> 59/60, GAGAL tepat di check ini.
    Sekalian: 6 label "header ... di grid" jadi "titik solder ... di grid",
    dan sisa komentar jumper/header pendarat di SCAD diselaraskan.
    Verifikasi: 60/60 lulus.
    [coaster_casing.scad]
2026-10-29 docs: hapus klaim LED yang tidak ada di kit, segarkan angka verifikasi
    Kit ini tidak memakai LED sebagai indikator, tetapi enam dokumen
    menjanjikannya ("LED berdenyut serempak", "getar & LED saja", "indikator
    cadangan"). GPIO2 hanya ada di sebagian board.
    - docs/garis_besar_sistem.md: diagram aktuator tanpa LED, tabel pin jujur,
    kalimat toggle dan tabel perintah `q` diperbaiki
    - CARA_UJI_HARDWARE.md, CLAUDE.md: LED ditandai tidak dipakai
    - config.h: komentar PIN_LED_ALERT menjelaskan pin tetap ditoggle
    - ino + web/index.html: teks "HENING (Getar & LED Saja)" -> "Getar Saja"
    - angka verifikasi disegarkan: CAD 59 -> 60, dan audit/handoff diberi
    catatan angka terbaru tanpa mengubah isi his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
2026-10-29 docs: betulkan klaim LED yang tersisa di handoff dan PRD
    Commit sebelumnya menyatakan LED tidak dipakai, tetapi HANDOFF_AGENT.md:11
    masih menulis "LED onboard di GPIO2 dipakai sebagai indikator alert
    pengganti" dan :98 menyarankan menulis ke PIN_LED_ALERT seolah LED aktif.
    PRD:37 juga masih menyebut GPIO2 "dihindari karena strapping pin + LED".
    - HANDOFF:11: LED hanya dipakai saat komponen hilang; sekarang tidak
    - HANDOFF:98: PIN_LED_ALERT tetap ditulis walau kit tidak memasang LED
    - PRD:37: alasan menghindari GPIO2 cukup strapping pin
    Sisa sebutan LED di PRD:39 dibiarkan: itu catatan historis kenapa motor
    dipindah dari GPIO2, dan isinya benar.
2026-10-29 docs: samakan catatan angka CAD di kembaran HTML audit
    AUDIT_SISTEM_DAN_WEB.md sudah diberi catatan "Per 2026-10-25: CAD 60/60",
    tetapi AUDIT_SISTEM_DAN_WEB.html masih menulis 59 pemeriksaan dan 59/59
    tanpa penunjuk. Kedua rendering kini sepakat.
    Verifikasi: tag HTML seimbang 152/152.
2026-10-29 feat(web): halaman masuk terpisah untuk akun dan klaim alat
    Form akun dulu menumpang di dashboard sebagai drawer, sehingga di HP
    mendorong seluruh isi ke bawah dan menyamarkan fakta bahwa Simulator
    tidak butuh akun sama sekali.
    Halaman baru web/login.html:
    - URL database, email, password, Web API Key dalam satu kartu
    - kartu klaim alat, hanya muncul saat sudah masuk dan alat belum tertaut
    - keadaan "sudah masuk" dengan tombol Buka dashboard dan Keluar
    - tautan keluar tanpa akun ke Simulator, USB Live, dan panduan rakit 3D
    Dashboard sekarang hanya menampilkan status akun selebar 41 px plus
    tautan Masuk/ganti akun. Dashboard membuka mode cloud bila datang dari
    index.html?mode=cloud.
    Perbaik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
2026-10-29 fix(web): panggil renderSessionState saat boot, jujur soal URL kosong
    Dua sisa dari pemisahan halaman akun:
    - renderSessionState() tidak pernah dipanggil lagi setelah form klaim
    pindah ke login.html, sehingga sessionBox selalu tersembunyi walau alat
    sudah tertaut. Sekarang dipanggil sekali saat boot.
    - Tombol "Kirim Wi-Fi & Cloud ke ESP32" diam-diam melewati URL karena
    input URL sudah pindah halaman, lalu tetap mencatat "Firebase terkirim".
    Sekarang pesan log membedakan dua keadaan dan menyebut di mana URL diisi.
    Verifikasi: tanpa device uid sessionBox tersembunyi, dengan device uid
    tampil; URL kosong menghasilkan perintah `w` saja tanpa `f`, dan log
    menyebut URL perlu diisi di hal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
2026-10-29 fix(web): sesuaikan halaman masuk dan dashboard untuk layar HP
    Halaman login baru tidak punya media query sama sekali, jadi di 360-412 px
    semua kontrol tinggal 36-42 px: di bawah batas 44 px yang sudah dipakai
    dashboard.
    - login.html: @media(pointer:coarse) naikkan kontrol ke 44 px, dan
    @media(max-width:420px) merapatkan padding, mengecilkan judul, serta
    menumpuk tombol aksi selebar penuh
    - index.html: a.act belum ikut aturan 44 px, jadi tautan "Masuk / daftar"
    tetap 38 px di layar sentuh
    Verifikasi di 360/375/390/412 px: tanpa overflow horizontal, dan tidak ada
    kontrol di bawah 44 px pada kedua halaman saat pointer:coarse aktif.
2026-10-29 fix(web): input 16px di layar sentuh supaya iOS tidak auto-zoom
    Semua input di login.html 13 px dan di index.html 12 px. iOS Safari
    memperbesar halaman begitu input difokus kalau ukuran font di bawah 16 px,
    lalu tidak kembali sendiri. Chromium tidak menunjukkan gejala ini, jadi
    pemeriksaan tinggi 44 px sebelumnya tidak menemukannya.
    - login.html: input{font-size:16px} di dalam @media(pointer:coarse)
    - index.html: sama, mencakup .conn-drawer input dan .cfg-row input
    Verifikasi: di 390 px dengan pointer:coarse aktif, semua input terukur
    16 px dan 44 px tinggi; tidak ada yang di bawah 16 px di kedua halaman.
2026-10-30 fix: hentikan polling saat app di latar, satukan label web, betulkan sisi wadah depan
    Tiga temuan audit repo.
    - app: _DashboardScreenState kini WidgetsBindingObserver. Timer 2,5 detik
    dihentikan saat app tidak terlihat dan langsung jalan lagi saat resumed.
    Sebelumnya ponsel di kantong tetap mengunduh tiap 2,5 detik.
    - web: blok penyetel label bDemo/bAutoMode/bMute di handleSerialLine menyalin
    isi applyTimerConfig(); diganti satu panggilan, supaya perubahan label tidak
    harus dikerjakan dua kali.
    - web/casing_3d.html: DHT11 dan HX711 bertukar sisi di teks pengguna. SCAD
    menaruh DHT11 di wadah depan kiri (x -24) dan HX711 di kanan (x +25); HTML
    menulis sebaliknya. Komentar scene di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
2026-10-30 docs(rakit): catat bahwa label papan berlawanan arah dengan indeks kolom SCAD
    Papan PY-5CM*7CM mencetak 18 di kiri dan 01 di kanan; SCAD menomori kolom
    dari kiri. Label panduan mengikuti cetakan (19 - k), bukan indeks SCAD.
    Tanpa catatan ini, label A10-A12 / D07-D10 / M01 / Q02-Q04 terbaca seperti
    kesalahan cermin padahal memang mengikuti papan fisik.
2026-10-30 fix(web): jangan timpa interval firmware saat label mode disegarkan
    Penyatuan label sebelumnya memanggil applyTimerConfig() dari handleSerialLine().
    Fungsi itu juga menjalankan recomputeAdaptive(), sehingga interval yang baru
    saja dibaca dari baris Target: ESP32 langsung ditimpa nilai lokal dan
    target_interval_min yang dikirim balik ke cloud jadi salah.
    Label dipisah ke syncModeLabels_(); jalur serial memakai itu saja. Diuji dengan
    frame NORM-MANUAL Target 1020s dan customBaseMin 30: fsm.interval tetap 17 menit.
    Sekalian betulkan dua komentar casing_3d.html: label kolom = 18 - k (k 0-based,
    motor k=17 bukan 18) dan pusat mesh hDht di x 3.81 memberi pin 1.27/3.81/6.35.
2026-10-30 feat(app): tanam URL Firebase di build, layar masuk tinggal email dan password
    Pengguna umum tidak lagi melihat URL RTDB, Web API Key, dan paragraf teknis.
    - project_config.dart: kFirebaseUrl dan kFirebaseApiKey dari --dart-define,
    URL proyek ini jadi default. Keduanya bukan rahasia; Firebase Rules yang
    menjaga data, dan keduanya memang dirancang untuk klien.
    - _urlValue/_keyValue mendahulukan isian pengguna, lalu tetapan build, jadi
    kolom yang muncul lewat "Ubah URL" benar-benar dipakai.
    - _boot() mendahulukan URL tersimpan di SharedPreferences supaya instalasi
    lama tetap jalan; tetapan build hanya cadangan.
    - RootPage menandai _editingUrl; tombol "Ubah URL" kini benar-benar
    memu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
2026-10-30 feat(web): halaman masuk cukup email dan password
    URL database dan Web API Key dipindah ke Pengaturan lanjutan (tertutup),
    nilainya ditanam di web/auth.js sebagai SHC_DEFAULT_URL / SHC_DEFAULT_API_KEY.
    - shcApiKey() dan shcBaseUrl() baru: isian pengguna menang, lalu tetapan.
    - getCleanFbUrl() dan jalur klaim memakai shcBaseUrl(), jadi dashboard tidak
    lagi bergantung pada localStorage saja.
    - localStorage hanya ditulis kalau pengguna mengetik sendiri, supaya tetapan
    tidak membeku di browser dan tetap bisa diperbarui lewat deploy.
    - Tanpa API key tertanam, pesan jelas: 'Web API Key belum diisi. Buka
    Pengaturan lanjutan.' Sebelumnya permintaan tetap dikirim dan gagal samar.
    Verifikasi d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
2026-10-30 fix(app): tetapan build menang atas API key basi di penyimpanan
    Key tersimpan ditulis otomatis oleh saveApiKey(), bukan diketik pengguna. Kalau
    ia menang atas kFirebaseApiKey, build dengan key baru tetap memakai key lama
    yang salah; kolomnya juga tersembunyi sehingga satu-satunya jalan keluar adalah
    hapus data aplikasi. Ini kebalikan dari URL, yang memang sengaja didahulukan
    karena diketik pengguna.
    - initState: _key.text diisi kFirebaseApiKey bila ada, bukan nilai tersimpan.
    - saveApiKey() hanya dipanggil saat tetapan build kosong, supaya tetapan tidak
    membeku di penyimpanan.
    - Test regresi: key basi di SharedPreferences tidak muncul, tetapan build yang
    dipakai.
    - CLAUDE.md: baris hala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
2026-10-31 feat(web): isi Web API Key proyek di tetapan bawaan
    Halaman masuk web kini benar-benar hanya email dan password: URL database dan
    Web API Key tidak lagi perlu diketik, hanya tersedia lewat blok tertutup
    Pengaturan lanjutan untuk pemasangan proyek lain.
    Nilai ini bukan rahasia; ia memang dirancang terpasang di klien. Nilai yang
    sama sudah ada di app/lib/project_config.dart sejak 014aa82. Yang menjaga data
    adalah Firebase Rules, dan kuota dijaga dengan API restrictions di Google Cloud
    (Identity Toolkit + Token Service saja), bukan dengan menyembunyikan key.
2026-11-01 fix(web): alamat data pakai UID akun, bukan UID alat
    ESP32 (cloud_sync.h signInWithPassword -> localId) dan aplikasi Flutter
    memakai UID akun sebagai pemilik node /users/<uid>/smart_coaster. Web
    memakai shcDeviceUid(), sehingga membaca dan menulis node yang tidak
    pernah ditulis klien mana pun: dashboard kosong tanpa error.
    UID alat tetap dipakai untuk /claims dan /links saat menautkan alat.
    Cache PWA dinaikkan supaya auth.js baru terpakai.
2026-11-02 feat(app): tautkan alat, node data pakai UID alat
    AuthSession hanya menyimpan UID akun dari login, sehingga coasterUrl()
    selalu menunjuk node akun sementara firmware (cloud_sync.h userNode())
    dan web PWA memakai node UID alat. Tanpa tautan, data alat tidak pernah
    terbaca.
    - AuthSession.deviceUid + hasDevice + copyWith
    - claimDevice(): /claims/<kode> -> /links/<akun>/<alat>
    - loadDeviceUid()/clearDeviceUid()
    - coasterUrl() pakai deviceUid, jatuh ke UID akun bila belum tertaut
    - ClaimScreen + tombol Tautkan/Ganti alat di panel Kontrol
    - deviceUid bertahan saat refresh token dan lintas restart
    - panel Kontrol: baris klaim jadi bertumpuk, Row+Expanded di dalam
    Column(stretch) membuat tombol t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
2026-11-02 feat(app): pulihkan tautan alat dari /links tanpa mengetik kode lagi
    signIn() tidak menghasilkan deviceUid dan _boot() tidak jalan setelah
    login, sehingga instalasi baru selalu mendarat di node akun meski alat
    sudah tertaut. Kini /links/<uid akun> dibaca sesudah boot dan sesudah
    login, dijalankan di latar supaya boot offline tidak tertahan.
    - discoverDevice(): baca /links/<uid akun>, ambil tautan terbaru,
    timeout 4 detik, gagal tidak menghentikan boot
    - RootPage/ConnectScreen meneruskan client ke signIn/refreshSession
    (sebelumnya jalur login tidak punya seam pengujian)
    - tes: 43 lulus, termasuk login baru dengan UID akun != UID alat
    Belum teruji di perangkat: HP terputus saat verifikas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
2026-11-02 fix(rules): izin baca daftar tautan di level ownerUid
    Izin RTDB tidak naik ke node induk. Tanpa .read di links/$ownerUid,
    permintaan GET /links/<uid akun>.json selalu 401 meski blok links lengkap
    (bukti: /claims/<kode> 200 tapi /claims.json 401). Akibatnya
    discoverDevice() tidak pernah berhasil dan selalu jatuh ke node akun.
    - firebase-rules.json: tambah .read di links/$ownerUid
    - auth.dart: catat syarat aturan di doc discoverDevice
    - tools/cek_aturan_firebase.py: periksa aturan konsol lewat REST,
    tanpa HP dan tanpa MockClient
    - tes: 44 lulus
2026-11-02 test(rules): garda berkas aturan Firebase
    Tes Dart tidak bisa menangkap bug aturan: MockClient selalu membalas 200,
    sedangkan di produksi GET /links/<uid>.json 401 karena .read hanya ada di
    $deviceUid. Alat ini memeriksa firebase-rules.json — berkas aturan adalah
    kode produksi, jadi ia butuh tesnya sendiri.
    Keluar dengan kode 1 kalau izin yang dibutuhkan klien hilang, sehingga
    bisa dipasang di alur verifikasi.
2026-11-02 tools: gagal cepat bila komit belum di-push
2026-11-02 fix(app): arahkan kode klaim ke Serial Monitor, bukan layar
    Tatakan tidak punya layar, tapi layar Tautkan alat menyuruh mencari kode
    di 'layar tatakan'. Firmware mencetaknya lewat Serial.printf di
    cloud_sync.h:223 dan :402, jadi instruksinya diarahkan ke Serial Monitor
    115200 baud.
    Sekalian: skrip rilis berhenti lebih awal kalau ada komit belum di-push,
    karena GitHub menolak SHA yang belum dikenal dengan 422 yang pesannya
    menyesatkan (menyebut tag_name juga).
2026-11-02 fix(copy): pesan kode salah arahkan ke Serial Monitor
    auth.dart:121 dan web/auth.js:73 masih menyuruh 'cek lagi di layar alat'
    — persis pesan yang muncul saat pengguna salah ketik kode yang dibaca
    dari log serial. Tatakan tidak punya layar.
    Tes baru mengunci pesan ini; gagal kalau teks lama dikembalikan.
2026-11-02 fix(firmware): parser login tahan spasi JSON pretty-print
    API identitytoolkit dan securetoken membalas ber-pretty-print:
    "idToken": "eyJ..." (ada spasi setelah titik dua)
    Parser lama mencari pola rapat "idToken":" sehingga selalu gagal.
    Gejalanya: login HTTP 200 dinyatakan gagal, return false tanpa cetakan
    apa pun, lalu cloudTask mengulang tiap 30 detik dalam senyap. Kode klaim
    tidak pernah dipublikasikan ke /claims.
    - jsonField(): lewati spasi sebelum/sesudah titik dua
    - dipakai di firebaseLogin (idToken, localId, refreshToken) dan
    firebaseRefresh (id_token, refresh_token) — keduanya kena masalah sama
    - cetak pesan saat parse gagal, sebelumnya senyap
    Tidak diubah: muted/mode/owner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
    [cloud_sync.h]
2026-11-02 fix(firmware): cetak diagnostik Wi-Fi, hilangkan titik buta senyap
    cloudTask hanya diam saat WiFi.status() != WL_CONNECTED, sehingga Wi-Fi
    yang gagal terhubung terlihat identik dengan login yang gagal: tidak ada
    satu pun baris cloud setelah boot, dan tidak ada cara membedakannya dari
    log serial.
    - startCloudIfNeeded(): cetak SSID yang dicoba, atau pesan eksplisit
    kalau SSID kosong (sebelumnya return tanpa sepatah kata)
    - cloudTask(): cetak status Wi-Fi tiap 10 detik selama belum konek,
    termasuk petunjuk bahwa ESP32 hanya bisa 2.4 GHz
    Kompilasi esp32:esp32:esp32doit-devkit-v1 berhasil (80% flash).
    [cloud_sync.h]
2026-11-02 fix(firmware): cabang diagnostik yang mustahil, urutan cetak benar
    Tiga cacat pada diagnostik sebelumnya:
    - cabang 'URL Firebase kosong' ditempatkan di dalam cloudTask, padahal
    cloudTask hanya dibuat ketika URL terisi -- mustahil tercapai, justru
    kasus yang perlu didiagnosis (secrets.h tidak ter-compile) tetap bisu
    - cetakan 'tersambung' disiapkan di jalur yang salah: harus setelah gerbang
    WiFi.status(), sekali-tembak, bukan saat WiFi.begin() dipanggil
    - ringkasan konfigurasi diletakkan di initCloudSync() sebelum Wi-Fi dicoba
    Urutan diagnostik saat boot: kode klaim (NVS) -> konfigurasi (panjang ssid/
    url/key/email) -> SSID yang benar-benar dipakai -> tersambung + IP ->
    login -> publik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
    [cloud_sync.h]
2026-11-03 feat: realtime SSE, TLS persisten, portal WiFi, paritas web-app
    Firmware:
    - satu WiFiClientSecure+HTTPClient dipakai ulang sepanjang cloudTask (TLS 8x lebih sedikit)
    - push telemetry hanya saat data berubah + heartbeat 60 dtk (hb)
    - poll config 3 dtk -> 1 dtk
    - PATCH config gagal dipasang ulang (maks 3 percobaan)
    - portal WiFiManager Coaster-Setup, kredensial ke NVS
    Web:
    - EventSource untuk telemetry dan config, put+patch menurut path
    - poll 2,5 dtk -> 20 dtk sebagai jaring aman
    - timer_mode dan manual_interval_min dari cloud ikut diterapkan
    - render() menyegarkan label mode
    - sw.js: js/css network-first, cache v13
    App:
    - streaming HTTP dengan reconnect + refresh token otomatis
    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
2026-11-03 fix(app): izin notifikasi runtime, clamp pengingat, stream config
    Empat bug nyata yang membuat fitur pengingat tampak berhasil di uji
    tetapi gagal di ponsel:
    - POST_NOTIFICATIONS tidak pernah diminta saat runtime. targetSdk 36
    membuat notify() dibuang diam-diam di Android 13+: alarm berbunyi
    tanpa apa pun terlihat. Diminta saat pengingat dinyalakan, dengan
    penolakan ditangani.
    - clamp lead satu menit menggeser jadwal alat: mode demo 15 dtk
    berbunyi setelah minum lewat. Batas bawah jadi 5 dtk.
    - ganti suara tidak menjadwalkan ulang, padahal suara ikut extras
    PendingIntent: alarm lama tetap memakai suara lama.
    - _cfg tidak punya stream, jadi mute/mode dari web tampak basi
    sampai p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
2026-11-03 fix(app): kanal getar terpisah, AppBar muat di layar sempit, alat tangkap layar
    - pilihan getar OFF diabaikan: kanal Android 8+ menyimpan setelan getar saat
    dibuat, dan setVibrate per-notifikasi tidak menggantikannya. Dua kanal
    dengan ID stabil (ON/OFF), pilihan diteruskan ke receiver dan service.
    - judul AppBar meluap 58 px di layar 390 px; dibungkus Expanded + ellipsis.
    - MainActivity ditulis ulang: penggantian berbasis rentang teks sempat
    menduplikasi seluruh object Reminder.
    - helper rememberScheduled dihapus: tanpa pemanggil, dan waktu tersisa sudah
    dibaca dari alarm yang terpasang.
    - test/golden_capture.dart: alat tangkap layar aplikasi lewat MockClient.
    Namanya sengaja tanpa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
2026-11-03 fix: air adaptive icon diklip, USB Live membawa mode, pemutar tidak menumpuk
    - ic_launcher_foreground.xml: air digambar sebagai persegi panjang tanpa klip,
    sehingga menonjol keluar dinding gelas yang meruncing di Android 8+. Sekarang
    dibungkus group + clip-path; garis luar digambar terakhir agar tetap tegas.
    Diverifikasi lewat pratinjau SVG hasil terjemahan drawable, bukan PNG.
    - pill 'USB Live' di login mendarat di Simulator: href tidak membawa mode, dan
    index.html hanya mengenali mode=cloud. Sekarang ?mode=usb dikenali.
    - ReminderSoundService: onStartCommand menimpa player/wake tanpa melepas yang
    lama. Dua alarm berdekatan menumpuk pemutar, dan callback completion lama
    melepas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
2026-11-03 feat(brand): logo baru — gelas di atas tatakan, satu sumber SVG
    Tanda: gelas di atas tatakan dilihat sedikit dari atas. Siluet ini yang
    membedakan produk (benda yang diukur dari bawah), bukan logo gelas tegak
    yang dipakai semua aplikasi air minum.
    - brand/: tanda dan kuncian (horizontal, vertikal) dalam versi terang dan
    gelap, SVG + PNG 2x
    - satu generator (brand/tools/build-brand.py) menulis keenam SVG dan
    web/icon.svg, jadi bentuk tidak bisa menyimpang antarberkas
    - nama produk diubah ke bentuk (path) dengan Space Grotesk Bold dari aset
    aplikasi, supaya tampil sama di komputer tanpa font itu
    - ikon Android: adaptive icon vektor + lima PNG legacy diregenerasi
    - PANDUAN-LOGO.md: war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
2026-11-03 fix(brand): PNG 3x dengan bukti ukuran, generator menulis semua aset
    Empat bug yang tertangkap setelah commit sebelumnya:
    - web/icon.svg di disk masih keluaran lama: clipPath membawa transform sendiri
    padahal sudah dirujuk dari dalam grup yang ditransformasi, jadi air terpotong
    dua kali. Rim stroke juga masih 11, bukan 9.
    - ic_launcher_foreground.xml menyimpang dari logo: permukaan air y=252
    sementara logo y=286. Generator sekarang MENULIS drawable Android juga.
    - logo-horizontal dan vertikal hanya 1723x400 dan 1104x575: deviceScaleFactor
    3 diabaikan browser, tangkapan tetap 1,25x. Ekspor ulang pada viewport 2,4x
    menghasilkan 4183x960 dan 2649x1380 (354 mm pada 300 DPI, sampul A4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
2026-11-03 fix(brand): ikon memakai varians gelap yang sama, tanpa salinan geometri
    - icon() menyalin geometri mark() manual dan menyimpang sekali (air y=252 vs
    286). Sekarang mark('dark') dipakai apa adanya, jadi ikon tidak bisa
    berbeda dari logo.
    - Ikon berlatar #071219 dengan badan gelas #143440: pada latar #0C1F27 badan
    gelas menyatu dengan latar dan hanya cincin mulut yang terlihat (terbukti di
    render 16-192 px).
    - clipPath tambahan yang membawa transform dihapus; koordinat klip mengikuti
    ruang elemen perujuk, transform ganda memotong air di tempat salah.
    - android_foreground() memakai palet varian gelap yang sama, bukan angka versi
    terang.
    - Kepala drawable menyebut fungsi pembuatnya.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
2026-11-03 feat: penghitung harian jujur, heartbeat dibaca klien, satu format angka
    Batch 1 dari audit. Alat tidak punya jam (tanpa NTP), jadi angka 'harian'
    dihitung di klien: selisih terhadap nilai saat tanggal berganti.
    - web: baseline per tanggal di localStorage; ganti hari dan reset di alat
    memasang baseline baru (tanpa itu selisih negatif dan minum hilang).
    - web: 'Progres target harian' -> 'Hari ini'; angka kumulatif diberi label
    'total sejak reset'.
    - web: node /daily/<tanggal> kini berisi angka harian, bukan kumulatif;
    app membacanya sebagai riwayat.
    - app: field hb dibaca, status 'Alat tidak mengirim data (N dtk)' setelah
    90 dtk tanpa kenaikan counter. Berat dan suhu bisa identik ant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
2026-11-03 fix(firmware): portal WiFi tidak lagi memblokir sampling
    Batch 2 dari audit. autoConnect() menahan core 1 sampai 180 dtk: selama portal
    terbuka, sampling 10 Hz dan gerbang stabilitas 1,5 dtk berhenti, sehingga tidak
    ada gelas yang terdeteksi selama pengguna mengisi sandi WiFi.
    - portal diproses dari loop() lewat handleWifiPortal(), satu putaran server per
    iterasi; pengukuran tetap jalan
    - while (WiFi.status() != CONNECTED) 20 dtk diganti checkWifiStale(): setelah
    30 dtk gagal konek, portal dibuka dari loop
    - delay(500) di setup dihapus
    - nama dan sandi AP pindah ke config.h (PORTAL_AP_NAME/PASS), bisa diganti
    lewat secrets.h tanpa menyentuh logika
    Compile 88% flash. 52 pemeriksaan C+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
    [SmartHydrationCoaster.ino, cloud_sync.h, config.h]
2026-11-03 fix(a11y): heading web, label app naik ke 11 px, sasaran jari 44 px
    Batch 3 dari audit.
    - dokumen tidak punya satu pun heading: ditambah h1 tersembunyi dan h2 per
    bagian, jadi pembaca layar bisa melompat antarwilayah
    - riwayat memakai h2 sungguhan, bukan span dekoratif
    - sasaran sentuh 37 -> 0 di bawah 44 px. Aturan dipicu lebar layar, bukan
    (pointer: coarse): sebagian browser melaporkan pointer halus di ponsel,
    sehingga aturan berbasis pointer tidak pernah berlaku. Spesifisitas
    disamakan dengan aturan dasar agar menang.
    - label kapital jadi sentence case (KONTROL -> Kontrol, dst), sejalan web
    - teks 10 px dinaikkan ke 11 px (15 pemakaian)
    - sel hitungan diberi Semantics: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
2026-11-03 fix(type): skala 7 langkah, bobot maksimum 600, spacing ke grid 4 px
    Batch 4 dari audit.
    - 12 ukuran font -> 7 (11,12,16,20,24,28,38). Langkah 13/15/18/22/32 dipetakan
    ke tetangga terdekat; 14 dihapus.
    - semua bobot 700 -> 600, termasuk <b>/<strong> yang mendapat 700 dari agen
    pengguna. Hierarki kini dari ukuran, bukan bobot.
    - semua padding/margin/gap di CSS ke kelipatan 4 (37 nilai). Diverifikasi di
    browser: 0 nilai off-grid, tanpa overflow.
    - label kapital -> sentence case, teks 10 px -> 11 px
    - padding 14 -> 16 dan 10 -> 12
    55 tes Flutter, 22 tes web lulus. APK terbangun.
    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
2026-11-03 chore: README, artefak keluar dari git, CI menjalankan semua gerbang
    Batch 5 dari audit.
    - README.md: isi repo, cara menjalankan ketiga surface, perintah verifikasi,
    catatan rancangan (tanpa jam, heartbeat, kanal notifikasi)
    - bukti-screenshot/ dan goldens keluar dari git: artefak pengumpulan dan
    keluaran alat tangkap, bukan kode; .gitignore menutupnya
    - CI: harness C++ (uji_fsm) dan verify_stackup kini dijalankan; job test-app
    terpisah menjalankan flutter analyze + test; pemicu diperluas ke
    SmartHydrationCoaster/**
    - GEMINI.md: class CoasterFSM ada di web/fsm.js, bukan web/index.html
    - CLAUDE.md: poll config 1 dtk dan SSE (bukan 15 dtk dan poll 2,5 dtk)
    - enam laporan audit lama di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
2026-11-03 fix: rujukan mati, bobot font nyata, README jujur, golden segar
    Empat temuan review, semuanya terverifikasi di kode:
    - CLAUDE.md menunjuk AUDIT_DESIGN_3D.md yang sudah diarsipkan; diperbaiki ke
    docs/arsip/. AUDIT_SISTEM_DAN_WEB.html yatim di root juga diarsipkan.
    - Space Grotesk dimuat 400;500;700, jadi font-weight:600 jatuh ke 700 dan
    pengurangan bobot tadi tidak berlaku untuk elemen display. 600 ditambahkan
    ke URL, diverifikasi document.fonts.check('600 ...') = true.
    App tidak punya SemiBold: w700 di heading turun ke w500 (Medium, nyata),
    jadi 700 = 0 di app.
    - README: uji_fsm.exe tidak dilacak git (hanya .cpp), diganti perintah
    kompilasi; tabel folder dilengkapi docs/; 'Lisen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
2026-11-03 feat(app): kartu target harian, dan dua bug yang tertangkap karenanya
    - Kartu 'Hari ini' dengan progres terhadap target 2000 ml. Baseline tanggal
    disimpan di SharedPreferences: alat tidak punya jam, jadi angka harian
    adalah selisih terhadap nilai saat tanggal berganti.
    - Bug 1: jalur poll tidak pernah menghitung hari ini maupun heartbeat. Hanya
    jalur SSE. Saat stream mati (proxy memblokir event-stream), status dan target
    harian membeku. Kedua jalur kini sama.
    - Bug 2: pada pembukaan pertama, baseline baru dipasang tetapi fungsi
    mengembalikan total kumulatif, sehingga kartu menampilkan 750/2000 ml (38%)
    padahal tidak ada yang diminum hari ini. Sekarang 0.
    Terlihat dari tangkapan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
2026-11-04 chore: pindahkan enam laporan audit lama ke docs/arsip
    Perpindahan sebelumnya tertinggal di pohon kerja: berkas sudah ada di
    docs/arsip/ tetapi penghapusannya belum di-commit. Rujukan di CLAUDE.md dan
    PRD sudah memakai path baru.
2026-11-04 fix(firmware): portal WiFi akhirnya benar-benar menyambung
    Log Serial Monitor menunjukkan tiga masalah nyata:
    - Setelah portal menyimpan kredensial, tidak ada yang memanggil WiFi.begin().
    Di mode non-blocking, startConfigPortal() tidak menyambung sendiri. Alat
    berputar: portal ditutup 180 dtk, checkWifiStale membukanya 30 dtk kemudian,
    berulang. Kredensial pengguna tidak pernah dicoba. Sekarang penyimpanan
    memulai koneksi.
    - addParameter() dipanggil di setiap pembukaan portal dan menumpuk, sehingga
    formulir portal berisi field ganda pada pembukaan ketiga.
    - checkWifiStale() membuka portal baru selagi koneksi hasil portal masih
    berjalan. Sekarang diberi 30 dtk sebelum dinilai gag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
    [cloud_sync.h]
2026-11-04 feat(firmware): alat mengumumkan diri lewat mDNS untuk klaim tanpa Serial Monitor
    Kode klaim hanya dibuat di alat dan hanya dicetak ke Serial Monitor. Kalau log
    terlewat, kode hilang dan tidak ada cara mengambilnya lagi, karena RTDB hanya
    mengizinkan pembacaan node itu lewat token akun pemilik.
    Alat kini mengiklankan dirinya di LAN selama portal WiFi terbuka:
    - layanan <Kode>._shc._tcp, port 80
    - TXT code=<Kode> dan model=hydration-coaster
    Aplikasi Android (NsdManager) atau iOS (NWBrowser) dapat menemukannya, lalu
    menautkan lewat UID perangkat. Iklan berhenti saat alat tersambung atau portal
    ditutup. Izin ACCESS_NETWORK_STATE dan CHANGE_WIFI_MULTICAST_STATE ditambah ke
    manifest aplikasi.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
2026-11-05 feat(klaim): salin kode klaim ke node pemilik dan cetak status PUT
    Node /claims/<kode> hanya bisa dibaca setelah pemilik tahu kodenya, jadi
    halaman Akun tidak bisa mencari alat di sana. Firmware kini menulis salinan
    kode ke /users/<uid>/smart_coaster/claimCode, yang bisa dibaca pemiliknya.
    Tulisannya tetap sekali (gerbang claimDone). Kalau aturan claimCode belum
    dipasang di konsol, PUT ditolak 401 dan tidak diulang, jadi statusnya dicetak
    ke Serial. Tanpa baris itu, kegagalan tidak terlihat sampai tombol Cari alat
    menemukan apa-apa.
    Aturan claimCode ditambah ke firebase-rules.json dan belum di-deploy ke
    konsol.
    Compile 91% flash.
2026-11-05 fix(klaim): salinan kode terpisah dari gerbang claimDone
    Blocker: salinan /users/<uid>/smart_coaster/claimCode ditulis di dalam blok
    yang hanya jalan bila !claimPublished. claimPublished dimuat dari NVS
    (claimDone). Alat yang pernah mengklaim tidak akan menulis salinannya lagi
    setelah reflash, sehingga node pemilik tetap kosong, PUT tidak mencetak 401,
    dan tombol Cari alat tidak menemukan apa pun. Kegagalan tidak menunjuk ke
    penyebabnya.
    Salinan kini punya gerbang sendiri (claimMirrored / claimMirrorDone) dan jalan
    walau /claims sudah pernah ditulis. /claims tetap sekali tulis sesuai aturan.
    Compile 91% flash, 16% RAM.
    [cloud_sync.h]
2026-11-05 fix(mdns,klaim): MAC dari eFuse, backoff 1 jam, dan log gagal salinan
    Log alat menunjukkan mac=00:00:00:00:00:00. Portal hidup dalam mode AP saja dan
    antarmuka STA tidak aktif, jadi WiFi.macAddress() mengembalikan nol. TXT kini
    dibaca dari eFuse (esp_efuse_mac_get_default), alamat yang sama dengan MAC STA.
    Salinan kode klaim juga belum punya batas percobaan: 401 dari aturan yang belum
    dipasang akan mengulang PUT tiap putaran cloudTask. Kini ditunda satu jam dan
    dicetak sekali, sama seperti /claims. Tanpa baris cetak itu kegagalan salinan
    tidak bisa dibedakan dari 'belum pernah dicoba'.
    Pesan status Wi-Fi tidak lagi menyimpulkan pita 5 GHz; status 6 berarti terputus,
    penyebabnya bisa sandi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
    [cloud_sync.h]
2026-11-05 feat(klaim): cetak bukti PUT salinan berhasil
    Sebelumnya hanya kegagalan yang dicetak, jadi 'berhasil' dan 'belum pernah
    dicoba' terlihat sama di Serial. Log alat pengguna tidak bisa dipakai
    memastikan salinan jalan.
    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
2026-11-05 fix(klaim): verifikasi isi node sekali per boot
    Gerbang claimMirrorDone di NVS hanya ditulis saat PUT 200, lalu dipercaya
    selamanya. Kalau node dihapus, atau akun berganti sementara tanda lama masih
    tersimpan, salinan tidak pernah ditulis lagi dan tombol Cari alat terus
    mengatakan belum ada alat. Tidak ada cara pulih selain menghapus NVS.
    Sekali per boot isi node dibaca. Bila GET 200 dan kodenya tidak cocok, gerbang
    dibuka dan PUT diulang di putaran yang sama. GET yang gagal tidak mengubah apa
    pun, jadi jaringan buruk tidak memicu tulis berulang.
    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
    [cloud_sync.h]
2026-11-05 fix(klaim): backoff pada verifikasi node yang gagal dibaca
    Verifikasi GET baru diulang tiap putaran cloudTask (250 ms) bila begin atau
    GET gagal, karena claimMirrorChecked hanya diset saat 200. Itu pola pembakaran
    kuota yang sama dengan PUT. Kini gagal baca menunda percobaan satu jam, dan
    PUT tidak terpengaruh karena gerbangnya bergantung pada claimMirrored.
    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
    [cloud_sync.h]
2026-11-05 fix: hitung waktu berjalan di klien, kunci target siklus, rapikan status akun
    Empat keluhan pengguna, enam perbaikan.
    Countdown membeku lalu melompat karena firmware sengaja tidak mengirim
    remaining_sec saat nilainya berubah (hanya heartbeat 60 dtk). Web dan aplikasi
    kini menghitung sendiri dari snapshot terakhir: sisa = remSaatKirim - waktu
    sejak diterima. Nol tulisan tambahan ke Firebase.
    Aplikasi juga menjadwalkan alarm dari angka basi itu. Sekarang memakai hitungan
    lokal yang sama, jadi pengingat tidak meleset sampai satu menit.
    Target yang bergerak di tengah siklus bisa memenuhi elapsed >= target dan
    memicu alarm lebih awal (30 menit bisa berbunyi di menit 19). FSM mengunci
    target sa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
    [SmartHydrationCoaster.ino, fsm.h]
2026-11-06 feat(brand): sticker untuk casing kuning mustard
    Casing dicetak kuning #EDB651. Logo biasa tidak bisa ditempel di atasnya:
    cyan #44C8E6 di atas kuning hanya 1,3:1, garis tatakan hilang. Versi sticker
    memakai tinta gelap untuk nama dan badan gelas, air tetap cyan tetapi selalu
    di dalam badan gelas, dan tatakan diberi muka putih tulang.
    Tiga berkas: kuncian horizontal, tanda saja, dan pratinjau di bidang kuning.
    Semuanya dari generator yang sama dengan logo lain, jadi bentuknya tidak bisa
    menyimpang. PNG 3300x1080, 1080x1080, dan 3876x1656, cocok dengan 3x viewBox
    yang sudah dipakai berkas lain.
    CATATAN: ekspor PNG lewat halaman data: menghasilkan berkas kosong tanpa galat,
    karena data: tida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
2026-11-06 fix(countdown): jangkar hanya maju saat snapshot benar-benar baru
    Poll 20 detik terhadap heartbeat 60 detik mengirim ulang telemetri yang sama,
    dan event config memutar ulang snapshot itu juga. Karena jangkar countdown
    dipasang di setiap kedatangan, angka kembali ke nilai awal tiap poll lalu
    turun lagi: terlihat melompat, dan jadwal alarm ikut mundur.
    Web dan aplikasi kini menandai frame baru dari counter hb. Firmware lama tanpa
    hb memakai pembanding nilai mentah yang terakhir diterima, bukan hitungan
    lokal, karena hitungan lokal selalu lebih kecil dan snapshot identik akan
    selalu dianggap baru.
    Diuji di browser: hb sama -> jangkar diam, 10:00 turun ke 09:54; hb naik ->
    jangkar maju ke 09: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
2026-11-06 feat(web): layar perkenalan untuk pengunjung expo
    Dashboard tidak bisa menjelaskan alat kepada orang yang baru berhenti di meja:
    yang terlihat pertama adalah angka berat dan tombol mode. Sekarang halaman
    dibuka dengan satu layar yang menyebut benda, manfaat, dan tiga angka nyata,
    lalu tombol 'Coba simulator' membuka dashboard yang sama tanpa memuat ulang.
    Palet tidak berubah: tetap tinta #0C1F27, panel #132B35, cyan #44C8E6. Marka
    logo dipakai apa adanya di panel kanan.
    Diuji di browser: 1280x900 tanpa scroll dan tanpa overflow horizontal; 390x844
    satu kolom dengan gambar lebih dulu; klik 'Coba simulator' menampilkan
    dashboard (main=grid, conn-bar=flex) dan simulator tetap berjalan.
    ?mode=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
2026-11-06 fix(countdown): buang hasil poll yang lebih tua dari frame live
    Poll 20 detik dan SSE berjalan bersamaan. Bila sebuah push tiba setelah poll
    berangkat, hasil poll membawa hb lama; menerapkannya memundurkan countdown dan
    menunda alarm.
    Kedua klien kini mencatat waktu frame live terakhir. Hasil poll hanya dipakai
    kalau tidak ada frame yang masuk sejak permintaan berangkat; config-nya tetap
    diterapkan. Perbandingan hb tidak dipakai karena counter bisa reset saat alat
    reboot.
    Diuji di browser: poll yang disusul frame live tidak mengubah sisa waktu
    (500 tetap 500) dan tidak menurunkan hb; poll tanpa frame baru tetap dipakai
    (420, hb 7). flutter analyze bersih, 56 tes Flutter lulus.
2026-11-06 fix(sync): config dan telemetri dari poll tidak lagi menimpa frame stream
    Dua sisa staleness yang lolos dari perbaikan sebelumnya:
    - patch config di web memutar ulang snapshot SSE terakhir, padahal poll yang
    diterima sesudahnya sudah lebih baru. Countdown bisa mundur sesaat.
    - hasil GET config selalu menimpa mute/mode yang baru dikirim lewat stream,
    karena guard-nya hanya ada di telemetri. Kini config punya penandanya sendiri
    di web (lastCfgStreamAt) dan di aplikasi (_cfgFrameAt).
    Saat config hasil poll sudah basi, web memakai config terakhir dari stream,
    bukan null: null membuat mute jatuh ke salinan di telemetri yang bisa lebih tua
    lagi.
2026-11-06 fix(web): satu poll pada satu waktu
    Timer 20 detik dan event config bisa memulai dua GET bersamaan. Bila yang
    berangkat lebih dulu selesai lebih akhir, snapshot lamanya menimpa yang baru
    dan countdown melompat naik. pollCloudOnce kini memakai penjaga pollBusy
    dengan finally, sama seperti _poll di aplikasi.
    Teruji: panggilan kedua saat poll berjalan tidak mengirim permintaan, dan poll
    berikutnya tetap bekerja.
2026-11-06 feat(sesi): mode DEMO lewat cloud, sesi bisa diakhiri, alat tidur saat sesi tutup
    Tiga hal yang saling terkait, semuanya soal kendali sesi dari klien.
    1. Mode demo akhirnya bisa dipilih dari web dan aplikasi. Sebelumnya 15 dtk
    hanya hidup sebagai perintah serial, jadi pilihan di layar tidak berpengaruh
    saat alat dijangkau lewat cloud. config.json kini menerima timer_mode DEMO.
    2. session.json membawa active. Akhiri sesi menulis active:false, dan alat masuk
    tidur: berat tidak dinilai, alarm dan timer berhenti, aktuator dipastikan
    mati, sementara telemetri tetap jalan supaya keadaan itu terlihat.
    3. Bangun dari tidur memakai fsm.toIdle(): siklus lama tidak dilanjutkan, karena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
2026-11-06 feat(sesi): perintah tidur dari kabel, SessionGate, dan kendali sesi di aplikasi
    Perintah tidur lewat kabel (z/x) sebelumnya langsung dibatalkan poll sesi: alat
    tidur, lalu poll 10 detik membaca session.json yang masih aktif dan
    membangunkannya. Aturannya dipindah ke session_gate.h supaya bisa diuji di PC,
    dan justru itu yang dijaga: nilai cloud hanya menimpa perintah lokal saat
    nilainya benar-benar berubah, karena perubahan itulah tanda pengguna menekan
    tombol di klien. Harness C++ menguji 10 kasusnya, termasuk poll berulang yang
    tidak boleh membangunkan alat.
    Web: tombol sesi juga mengirim x/z saat mode USB, karena alat tidak membaca
    session.json di jalur kabel. Baris telemetri serial mem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
2026-11-06 fix(sesi): toIdle di kedua arah perpindahan sesi
    Saat tidur state FSM dibiarkan apa adanya, jadi telemetri dan laporan serial
    masih membawa ALERT_DRINK basi: di web dan aplikasi lencananya tetap merah
    padahal alat sedang tidur. Sekarang kedua arah memakai toIdle: saat tidur supaya
    state yang dilaporkan jujur, saat bangun supaya siklus lama tidak dilanjutkan.
    [SmartHydrationCoaster.ino]
2026-11-06 fix(sesi): DEMO tidak lagi terhapus, tidur cepat terkirim dan terasa
    Empat temuan yang semuanya bisa menggigit saat demo:
    1. config.json yang ditulis firmware tidak pernah memuat DEMO. Satu perintah
    serial apa pun (q/m/i/e/c/d) memicu configDirty, alat mem-PATCH AUTO_DHT atau
    MANUAL, lalu GET berikutnya mengembalikan demoMode=false: pilihan DEMO milik
    klien hilang sendiri.
    2. Perpindahan standby belum ikut dataChanged. Kalau alat sudah IDLE saat sesi
    ditutup, state-nya tidak berubah, jadi klien baru tahu alat tidur dari
    heartbeat 60 dtk.
    3. Poll sesi tetap 10 dtk di semua keadaan, padahal node yang sama kini membawa
    active:false: alarm bisa berbunyi sampai 10 dtk setelah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
    [SmartHydrationCoaster.ino, cloud_sync.h]
2026-11-06 fix(ui): tombol dialog sesi 44 px saat disentuh di ponsel
    Tombol Batal dan Mulai sesi bersebelahan, dan salah tekan di situ menggagalkan
    niat pengguna. Gaya .act global tetap 38 px; yang dinaikkan hanya tombol di
    dialog ini.
2026-11-06 feat(timer): beri tahu bahwa pengaturan baru dipakai siklus berikutnya
    Mengubah mode atau interval dasar saat alat sedang menghitung tidak mengubah
    siklus yang berjalan: siklus memegang target yang dicatat startCycle(), dan itu
    disengaja supaya target yang menyusut tidak memicu alarm lebih awal (paritas
    22a-23b). Yang tidak disengaja adalah pengguna menunggu dengan angka lama lalu
    mengira pengaturannya tidak masuk.
    Web dan aplikasi kini menampilkan peringatan saat pengaturan timer diubah ketika
    alat TIMING, menyebut target yang masih dipakai, dan melepasnya sendiri begitu
    target alat bergeser. Hanya TIMING yang diperingatkan: di ALERT_* dan LIFTED,
    aksi berikutnya (minum, isi ulang, taruh k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
2026-11-06 fix(salinan): janji timer hanya dari jalur yang benar-benar sampai ke alat
    Dua ketidaksesuaian kecil antara apa yang dikatakan layar dan apa yang benar-benar
    terjadi:
    - Dialog mulai sesi di mode USB tidak mengirim pilihan mode ke alat: tombol d/m/i
    yang mengirimnya satu per satu, sedangkan dialog hanya mengubah salinan lokal dan
    menulis RTDB. Catatan "pengaturan baru dipakai siklus berikutnya" di sana
    menjanjikan perubahan yang tidak pernah datang dari kabel. Sekarang catatan itu
    hanya dipasang di mode cloud, yang config.json-nya memang dibaca alat.
    - Kartu sisa waktu aplikasi menulis target dengan satu desimal (45.0 menit) sementara
    catatan peringatan memakai 45 menit untuk angk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
2026-11-07 chore(web): hapus panduan 3D yang tidak dipakai, dan buang istilah dapur
    - web/casing_3d.html dihapus, termasuk tautannya di halaman masuk dan di kaki
    dashboard. Sumber geometri tetap cad/coaster_casing.scad.
    - Baris status TIMING tidak lagi menyebut 'baseline', tapi 'berat awal NN g'.
    - Layar tautan alat di aplikasi tidak lagi memakai kata 'node': judulnya 'Alat',
    statusnya 'belum tertaut ke alat', dan tombol lewati menjadi 'Lewati untuk
    sekarang'. Istilah Firebase tidak muncul lagi di layar pengguna.
    Istilah lain yang disarankan audit teks saya biarkan: 'curang' adalah nama
    konsep yang dihitung sistem dan dipakai PRD, 'alat tidur' sudah dipilih sendiri,
    'Total sejak reset' memang bu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
2026-11-07 docs: dokumen hidup berhenti menautkan panduan 3D yang sudah dihapus
    - docs/garis_besar_sistem.md: paragraf viewer 3D dibuang; sekalian dibetulkan
    klaim mode cloud yang masih bilang 'poll 2,5 detik tanpa WebSocket' padahal
    jalurnya stream SSE plus poll 20 detik.
    - PRD: 'panduan perakitan 3D interaktif' diganti rujukan ke cad/coaster_casing.scad.
    - cad/coaster_casing.scad: catatan sumbu tidak lagi mengacu ke viewer Y-up yang
    tidak ada; posisi modul tetap seperti rakitan build.
    - CLAUDE.md: kalimat 'casing_3d.html sudah dihapus' juga dibuang, supaya dokumen
    hidup tidak menyebut berkas yang tidak ada.
    docs/arsip/ sengaja tidak disentuh: itu catatan audit bertanggal.
    Verifikasi: tools/c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
    [coaster_casing.scad]
